mfkiwl/GPSDO_by_DF4IAH/HW/CAD/Eagle/cam/ZIP/20211031_sGPSDO_MCU_1V0/Preview/20211031_sGPSDO_MCU_1V0__Eagle.jpeg

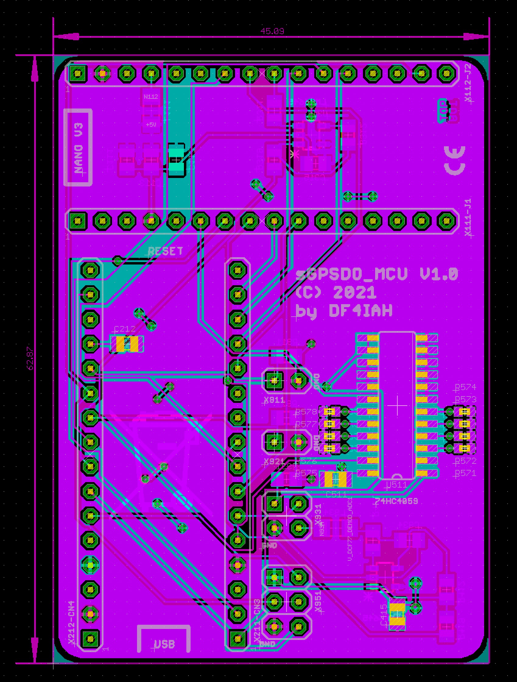
HW/CAD/Eagle/cam/ZIP/20211031_sGPSDO_MCU_1V0/Preview/20211031_sGPSDO_MCU_1V0__Eagle.jpeg
