mfkiwl/GPSDO_by_DF4IAH/README.md

# GPSDO_by_DF4IAH
GNSS or DCF77 disciplined OCXO based on hardware by DL4ZAO and DL7UKM.
