mfkiwl/GPSDO_by_DF4IAH/DOCS/01_MCU_Pinout/GPSDO_DF4IAH_STM32L432KC.jpeg

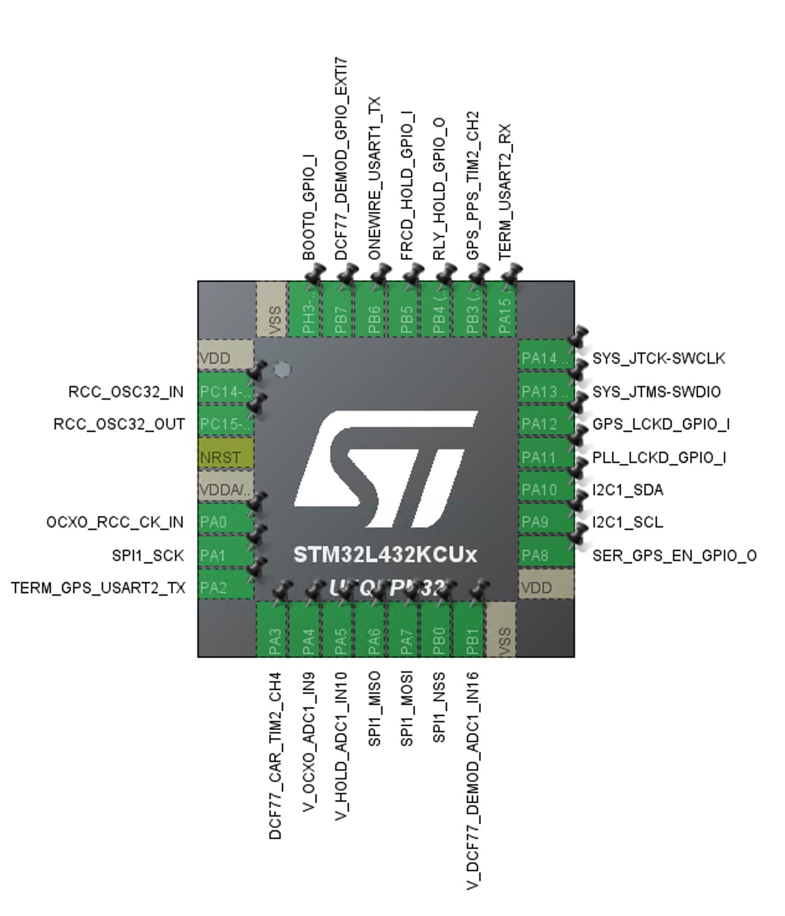
DOCS/01_MCU_Pinout/GPSDO_DF4IAH_STM32L432KC.jpeg
