mfkiwl/GPSDO_by_DF4IAH/HW/CAD/Eagle/cam/ZIP/20211025_DCF77_RX_1V0/Preview/Board_STP.jpeg

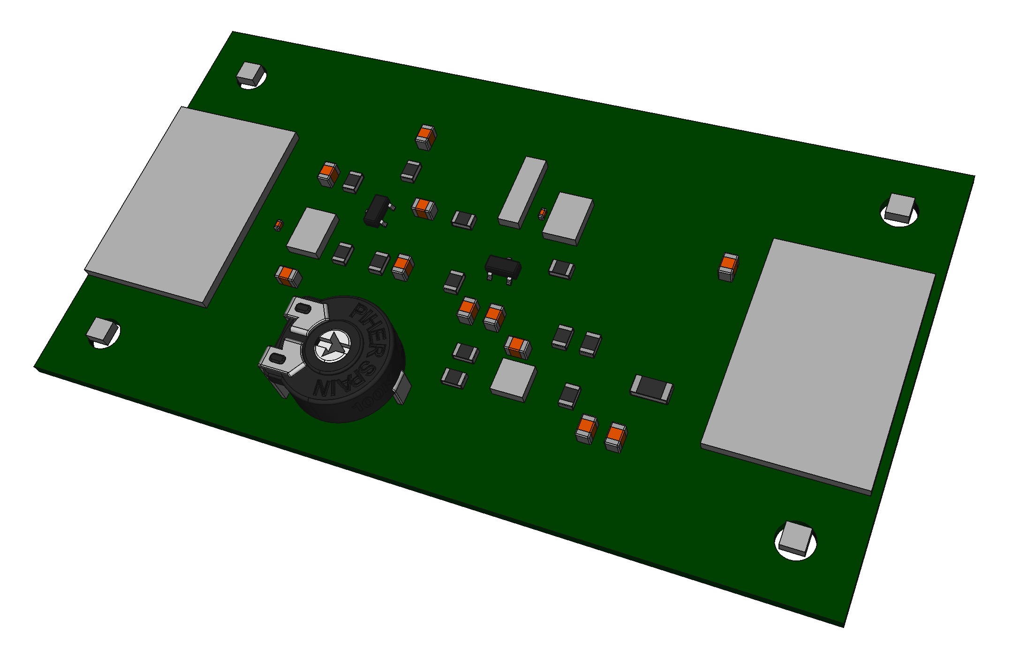
HW/CAD/Eagle/cam/ZIP/20211025_DCF77_RX_1V0/Preview/Board_STP.jpeg
