mfkiwl/GPSDO_by_DF4IAH/HW/CAD/Eagle/cam/ZIP/20211025_DCF77_RX_1V0/Preview/pp_top_6175b63559f43.jpeg

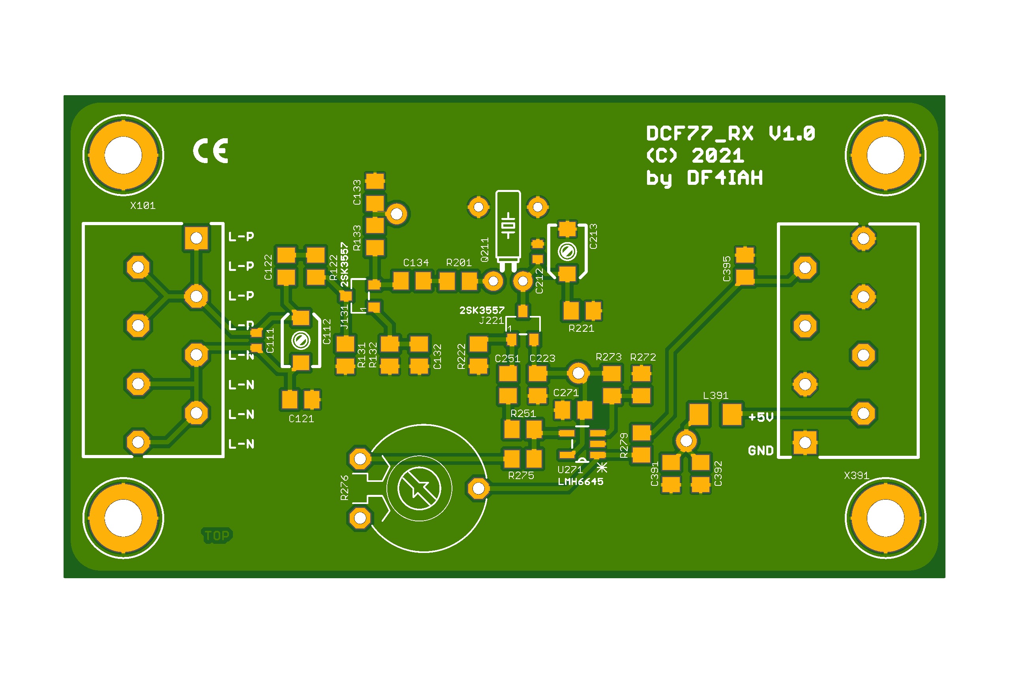
HW/CAD/Eagle/cam/ZIP/20211025_DCF77_RX_1V0/Preview/pp_top_6175b63559f43.jpeg
