mfkiwl/GPSDO_by_DF4IAH/HW/CAD/Eagle/cam/ZIP/20211031_sGPSDO_MCU_1V0/Preview/pp_bottom_617efd1f2c64e.jpeg

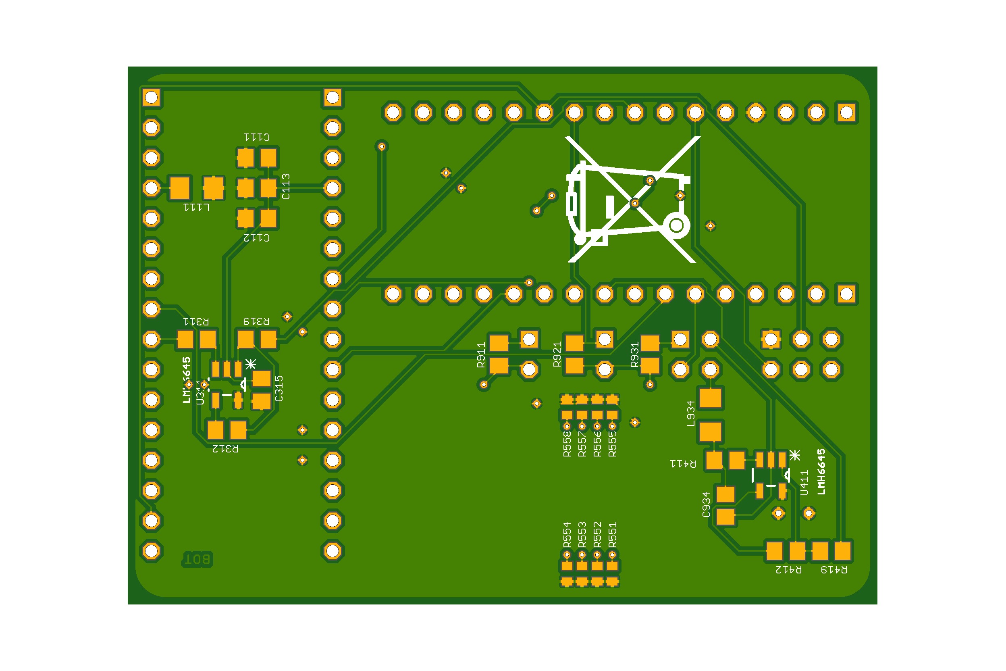
HW/CAD/Eagle/cam/ZIP/20211031_sGPSDO_MCU_1V0/Preview/pp_bottom_617efd1f2c64e.jpeg
