mfkiwl/GPSDO_by_DF4IAH/HW/CAD/Eagle/cam/ZIP/20211031_sGPSDO_MCU_1V0/Preview/pp_top_617efd0a4f2e5.jpeg

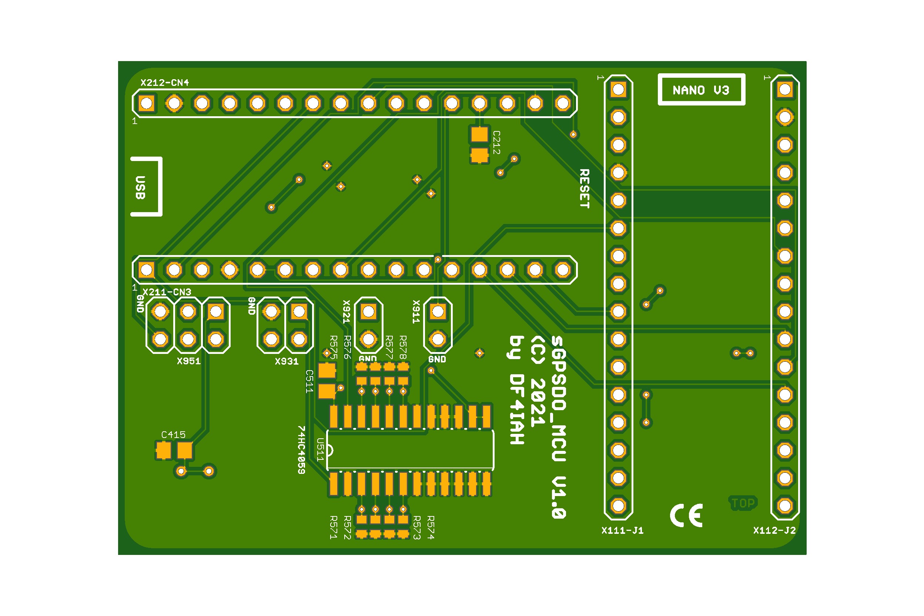
HW/CAD/Eagle/cam/ZIP/20211031_sGPSDO_MCU_1V0/Preview/pp_top_617efd0a4f2e5.jpeg
