mfkiwl/GPSDO_by_DF4IAH/CPLD/sGPSDO_MCU__divider/not_in_use/divider_test/div_mod_summary.html

div_mod Project Status (11/01/2021 - 13:03:21)
Project File: | divider_test.xise | Parser Errors: | No Errors
Module Name: | div_mod | Implementation State: | Fitted
Target Device: | xc2c64a-7VQ44 | Errors: | No Errors
Product Version: | ISE 14.7 | Warnings: | 2 Warnings (1 new)
Design Goal: | Balanced | Routing Results:
Design Strategy: | Xilinx Default (unlocked) | Timing Constraints:
Environment: | System Settings | Final Timing Score:

Detailed Reports | | | | | | [-]
Report Name | Status | Generated | Errors | Warnings | Infos
Synthesis Report | Current | Mon Nov 1 12:31:45 2021 | 0 | 1 Warning (1 new) | 0
Translation Report | Current | Mon Nov 1 13:03:12 2021 | 0 | 1 Warning (0 new) | 0
CPLD Fitter Report (Text) | Current | Mon Nov 1 13:03:14 2021 | 0 | 1 Warning (1 new) | 0
Power Report

Secondary Reports | | | [-]
Report Name | Status | Generated
Post-Fit Simulation Model Report

Date Generated: 11/01/2021 - 13:03:21
