mfkiwl/GPSDO_by_DF4IAH/CPLD/sGPSDO_MCU__divider/not_in_use/divider_test/div_mod_envsettings.html

System Settings

Environment Settings
Environment Variable | xst | ngdbuild
LD_LIBRARY_PATH | /opt/Xilinx/14.7/ISE_DS/ISE//lib/lin64: /opt/Xilinx/14.7/ISE_DS/ISE/lib/lin64: /opt/Xilinx/14.7/ISE_DS/ISE/smartmodel/lin64/installed_lin64/lib: /opt/Xilinx/14.7/ISE_DS/ISE/sysgen/lib: /opt/Xilinx/14.7/ISE_DS/EDK/lib/lin64: /opt/Xilinx/14.7/ISE_DS/common/lib/lin64 | /opt/Xilinx/14.7/ISE_DS/ISE//lib/lin64: /opt/Xilinx/14.7/ISE_DS/ISE/lib/lin64: /opt/Xilinx/14.7/ISE_DS/ISE/smartmodel/lin64/installed_lin64/lib: /opt/Xilinx/14.7/ISE_DS/ISE/sysgen/lib: /opt/Xilinx/14.7/ISE_DS/EDK/lib/lin64: /opt/Xilinx/14.7/ISE_DS/common/lib/lin64
LMC_HOME | /opt/Xilinx/14.7/ISE_DS/ISE/smartmodel/lin64/installed_lin64 | /opt/Xilinx/14.7/ISE_DS/ISE/smartmodel/lin64/installed_lin64

PATH

/opt/Xilinx/14.7/ISE_DS/ISE//bin/lin64:
/opt/Xilinx/14.7/ISE_DS/ISE/bin/lin64:
/opt/Xilinx/14.7/ISE_DS/ISE/sysgen/util:
/opt/Xilinx/14.7/ISE_DS/ISE/sysgen/bin:
/opt/Xilinx/14.7/ISE_DS/ISE/../../../DocNav:
/opt/Xilinx/14.7/ISE_DS/PlanAhead/bin:
/opt/Xilinx/14.7/ISE_DS/EDK/bin/lin64:
/opt/Xilinx/14.7/ISE_DS/EDK/gnu/microblaze/lin/bin:
/opt/Xilinx/14.7/ISE_DS/EDK/gnu/powerpc-eabi/lin/bin:
/opt/Xilinx/14.7/ISE_DS/EDK/gnu/arm/lin/bin:
/opt/Xilinx/14.7/ISE_DS/EDK/gnu/microblaze/linux_toolchain/lin64_be/bin:
/opt/Xilinx/14.7/ISE_DS/EDK/gnu/microblaze/linux_toolchain/lin64_le/bin:
/opt/Xilinx/14.7/ISE_DS/common/bin/lin64:
/usr/lib64/qt-3.3/bin:
/usr/local/bin:
/usr/bin:
/bin:
/usr/local/sbin:
/usr/sbin:
/sbin:
/home/ise/bin

/opt/Xilinx/14.7/ISE_DS/ISE//bin/lin64:
/opt/Xilinx/14.7/ISE_DS/ISE/bin/lin64:
/opt/Xilinx/14.7/ISE_DS/ISE/sysgen/util:
/opt/Xilinx/14.7/ISE_DS/ISE/sysgen/bin:
/opt/Xilinx/14.7/ISE_DS/ISE/../../../DocNav:
/opt/Xilinx/14.7/ISE_DS/PlanAhead/bin:
/opt/Xilinx/14.7/ISE_DS/EDK/bin/lin64:
/opt/Xilinx/14.7/ISE_DS/EDK/gnu/microblaze/lin/bin:
/opt/Xilinx/14.7/ISE_DS/EDK/gnu/powerpc-eabi/lin/bin:
/opt/Xilinx/14.7/ISE_DS/EDK/gnu/arm/lin/bin:
/opt/Xilinx/14.7/ISE_DS/EDK/gnu/microblaze/linux_toolchain/lin64_be/bin:
/opt/Xilinx/14.7/ISE_DS/EDK/gnu/microblaze/linux_toolchain/lin64_le/bin:
/opt/Xilinx/14.7/ISE_DS/common/bin/lin64:
/usr/lib64/qt-3.3/bin:
/usr/local/bin:
/usr/bin:
/bin:
/usr/local/sbin:
/usr/sbin:
/sbin:
/home/ise/bin
XILINX | /opt/Xilinx/14.7/ISE_DS/ISE/ | /opt/Xilinx/14.7/ISE_DS/ISE/
XILINX_DSP | /opt/Xilinx/14.7/ISE_DS/ISE | /opt/Xilinx/14.7/ISE_DS/ISE
XILINX_EDK | /opt/Xilinx/14.7/ISE_DS/EDK | /opt/Xilinx/14.7/ISE_DS/EDK
XILINX_PLANAHEAD | /opt/Xilinx/14.7/ISE_DS/PlanAhead | /opt/Xilinx/14.7/ISE_DS/PlanAhead

Synthesis Property Settings
Switch Name | Property Name | Value | Default Value
-ifn | | div_mod.prj
-ifmt | | mixed | MIXED
-ofn | | div_mod
-ofmt | | NGC | NGC
-p | | xbr
-top | | div_mod
-opt_mode | Optimization Goal | Speed | SPEED
-opt_level | Optimization Effort | 1 | 1
-iuc | Use synthesis Constraints File | NO | NO
-keep_hierarchy | Keep Hierarchy | Yes | YES
-netlist_hierarchy | Netlist Hierarchy | As_Optimized | as_optimized
-rtlview | Generate RTL Schematic | Yes | NO
-bus_delimiter | Bus Delimiter | <> | <>
-verilog2001 | Verilog 2001 | YES | YES
-fsm_extract | | YES | YES
-fsm_encoding | | Auto | AUTO
-safe_implementation | | No | NO
-resource_sharing | | YES | YES
-iobuf | | YES | YES
-equivalent_register_removal | | YES | YES

Translation Property Settings
Switch Name | Property Name | Value | Default Value
-intstyle | | ise | None
-dd | | _ngo | None
-p | | xc2c64a-VQ44-7 | None
-uc | | top_constraints.ucf | None

Operating System Information
Operating System Information | xst | ngdbuild
CPU Architecture/Speed | Intel(R) Core(TM) i9-10900K CPU @ 3.70GHz/3696.000 MHz | Intel(R) Core(TM) i9-10900K CPU @ 3.70GHz/3696.000 MHz
Host | localhost.localdomain | localhost.localdomain
OS Name | OracleServer | OracleServer
OS Release | Oracle Linux Server release 6.4 | Oracle Linux Server release 6.4
