mfkiwl/GPSDO_by_DF4IAH/CPLD/sGPSDO_MCU__divider/not_in_use/divider_test/C__/nppdf32Log/debuglog.txt

NPP_GetValue is called
NPP_GetValue is called
NPP_GetValue is called
NPP_GetValue is called
NPP_GetValue is called
NPP_GetValue is called
NPP_GetValue is called
NPP_GetValue is called
NPP_GetValue is called
NPP_GetValue is called
NPP_GetValue is called
NPP_GetValue is called
NPP_GetValue is called
NPP_GetValue is called
NPP_GetValue is called
NPP_GetValue is called
NPP_GetValue is called
NPP_GetValue is called
NPP_GetValue is called
NPP_GetValue is called
NPP_GetValue is called
NPP_GetValue is called
NPP_GetValue is called
NPP_GetValue is called
NPP_GetValue is called
NPP_GetValue is called
NPP_GetValue is called
NPP_GetValue is called
NPP_GetValue is called
NPP_GetValue is called
NPP_GetValue is called
NPP_GetValue is called
NPP_GetValue is called
NPP_GetValue is called
NPP_GetValue is called
NPP_GetValue is called
NPP_GetValue is called
NPP_GetValue is called
NPP_GetValue is called
NPP_GetValue is called
NPP_GetValue is called
NPP_GetValue is called
NPP_GetValue is called
NPP_GetValue is called
NPP_GetValue is called
NPP_GetValue is called
NPP_GetValue is called
NPP_GetValue is called
NPP_GetValue is called
NPP_GetValue is called
NPP_GetValue is called
NPP_GetValue is called
NPP_GetValue is called
NPP_GetValue is called
NPP_GetValue is called
NPP_GetValue is called
NPP_GetValue is called
NPP_GetValue is called
NPP_GetValue is called
NPP_GetValue is called
NPP_GetValue is called
NPP_GetValue is called
NPP_GetValue is called
NPP_GetValue is called
NPP_GetValue is called
NPP_GetValue is called
NPP_GetValue is called
NPP_GetValue is called
NPP_GetValue is called
NPP_GetValue is called
NPP_GetValue is called
NPP_GetValue is called
NPP_GetValue is called
NPP_GetValue is called
NPP_GetValue is called
NPP_GetValue is called
NPP_GetValue is called
NPP_GetValue is called
NPP_GetValue is called
NPP_GetValue is called
NPP_GetValue is called
NPP_GetValue is called
NPP_GetValue is called
NPP_GetValue is called
NPP_GetValue is called
NPP_GetValue is called
NPP_GetValue is called
NPP_GetValue is called
NPP_GetValue is called
NPP_GetValue is called
NPP_GetValue is called
NPP_GetValue is called
NPP_GetValue is called
NPP_GetValue is called
NPP_GetValue is called
NPP_GetValue is called
NPP_GetValue is called
NPP_GetValue is called
NPP_GetValue is called
NPP_GetValue is called
NPP_GetValue is called
NPP_GetValue is called
