mfkiwl/GPSDO_by_DF4IAH/HW/CAD/Eagle/DCF77_RX_1V0.pdf

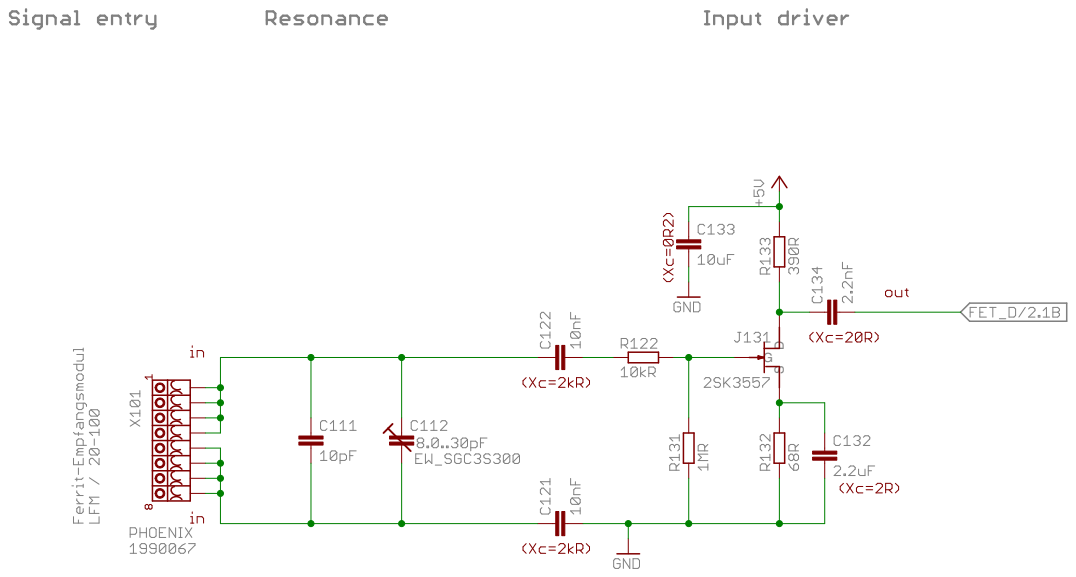
[picture p20: page 1]

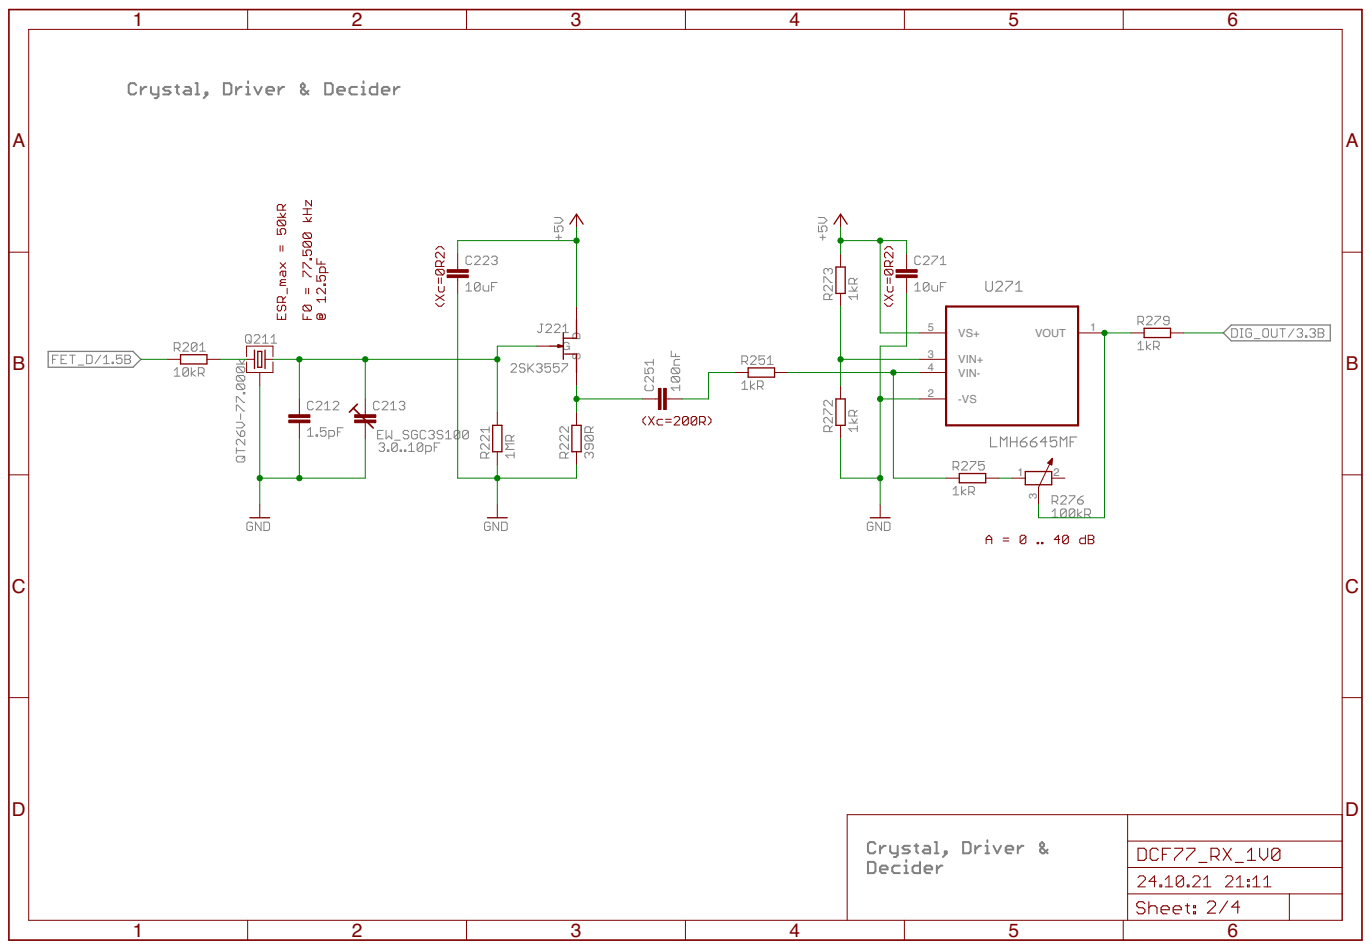
[picture p21: page 2]

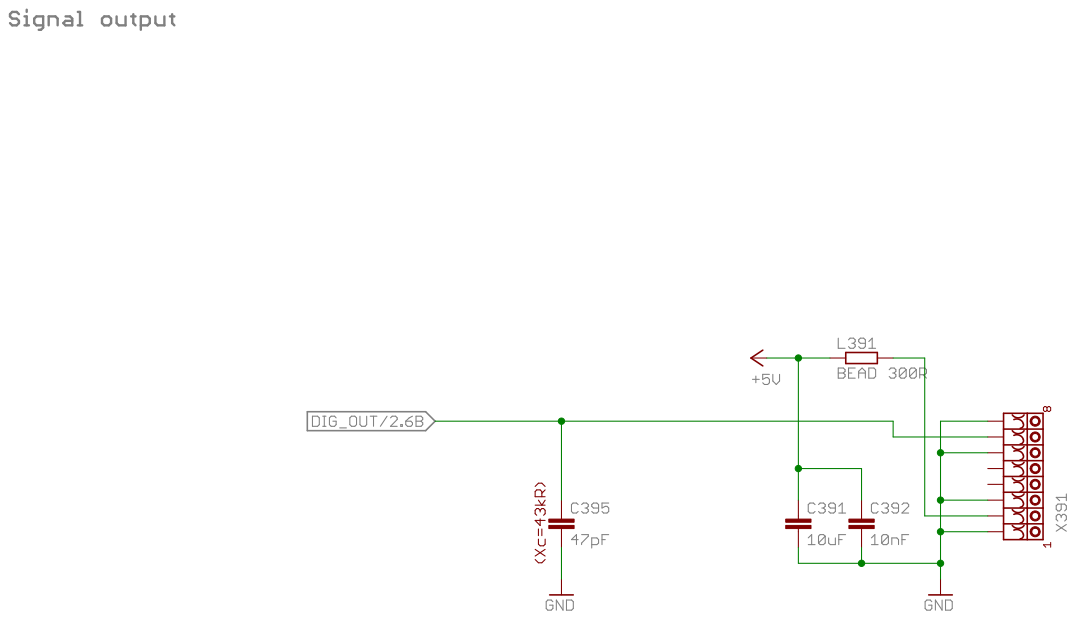
[picture p22: page 3]

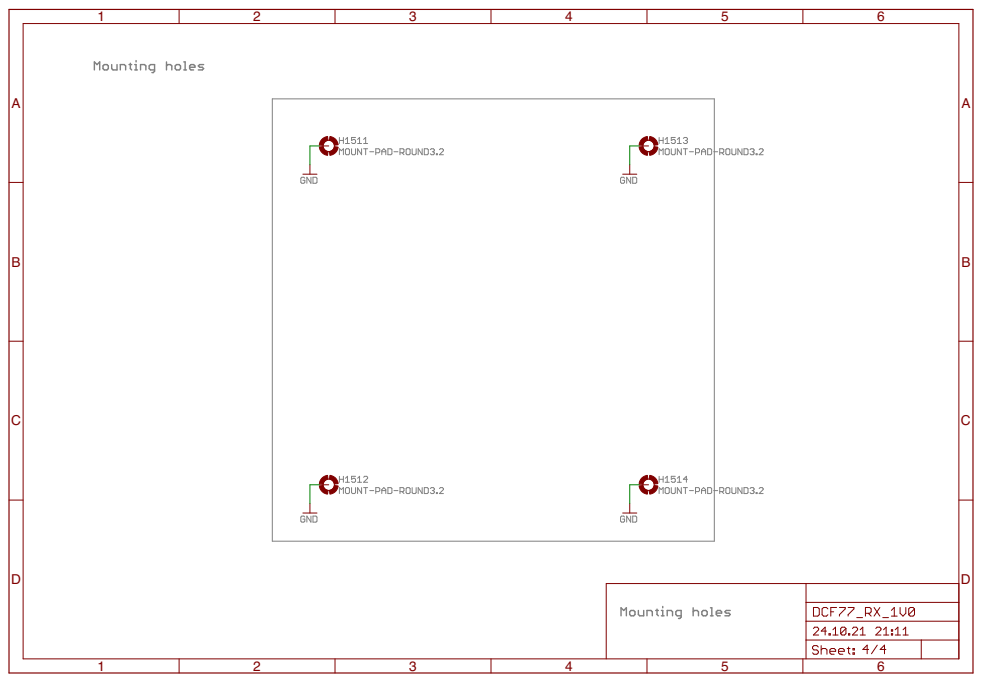
[picture p23: page 4]
