mfkiwl/GPSDO_by_DF4IAH/HW/CAD/LTspice_Simu/01_Crystal_AC-analysis.asc

C1: cap; 1p
C2: cap; 12.5p
L1: ind; 4.52
R1: res; 50k
R2: res; 10k
R3: res; 1Meg
V1: voltage; SINE(0 1m 77500); AC 1m 0
Named nets: 0, out, in
.ac oct 100 1000 1000000
