mfkiwl/GPSDO_by_DF4IAH/HW/CAD/LTspice_Simu/02_Crystal_and_nFET_AC-analysis.asc

C1: cap; 1p
C2: cap; 7.7p
C5: cap; 22n
J1: njf; 2SK3557
L1: ind; 4.52
R1: res; 50k
R2: res; 10k
R3: res; 1Meg
R4: res; 390
R8: res; 1k
R9: res; 1k
V1: voltage; SINE(0 1m 77500); AC 1 0
V2: voltage; 5
Named nets: 0, out1, in, v5v, out3
.ac lin 1000 50k 100k
