mfkiwl/GPSDO_by_DF4IAH/HW/CAD/LTspice_Simu/03_nFET_and_Crystal_and_nFET_AC-analysis.asc

C1: cap; 1p
C2: cap; 7.7p
C3: cap; 30p
C4: cap; 10n
C5: cap; 22n
C6: cap; 10n
C7: cap; 2.2µ
C8: cap; 2.2n
J1: njf; 2SK3557
J2: njf; 2SK3557
L1: ind; 4.52
L2: ind; 60m
R1: res; 50k
R2: res; 1Meg
R3: res; 1Meg
R4: res; 390
R5: res; 10k
R6: res; 10Meg
R7: res; 1Meg
R8: res; 1k
R9: res; 1k
R10: res; 68
R11: res; 390
R12: res; 10k
V1: voltage; SINE(0 1 77500); AC 5.623 0
V2: voltage; 5
Named nets: crystal, in, 0, v5v, driver, in2, preamp
.ac lin 1000 50k 100k
