mfkiwl/GPSDO_by_DF4IAH/HW/CAD/LTspice_Simu/04_nFET_and_Crystal_and_nFET__FET-fine-model_AC-analysis.asc

C1: cap; 1p
C2: cap; 8p
C3: cap; 30.5p
C4: cap; 10n
C5: cap; 22n
C6: cap; 10n
C7: cap; 2.2µ
C8: cap; 2.2n
C9: cap; 74f
C10: cap; 74f
C11: cap; 74f
C12: cap; 74f
J2: njf; 2SK3557
J3: njf; 2SK3557
L1: ind; 4.52
L2: ind; 60m
L3: ind; 132p
L4: ind; 924p
L5: ind; 524p
L6: ind; 132p
L7: ind; 924p
L8: ind; 132p
L9: ind; 924p
L10: ind; 524p
L11: ind; 132p
L12: ind; 924p
R1: res; 50k
R2: res; 1Meg
R3: res; 1Meg
R4: res; 390
R5: res; 10k
R6: res; 10Meg
R7: res; 1Meg
R8: res; 1k
R9: res; 1k
R10: res; 15
R11: res; 180
R12: res; 10k
V1: voltage; SINE(0 1.125 77500 0.001 0 0 120); AC 1.125 0
V2: voltage; 5
Named nets: crystal, in, 0, v5v, driver, in2, preamp, preamp_S
.ac lin 1000 50k 100k
Crystal
;op lin 1000 50k 100k
