mfkiwl/GPSDO_by_DF4IAH/HW/CAD/Eagle/sGPSDO_MCU_1V0.brd

## EAGLE design HW/CAD/Eagle/sGPSDO_MCU_1V0.brd (2021-10-31)

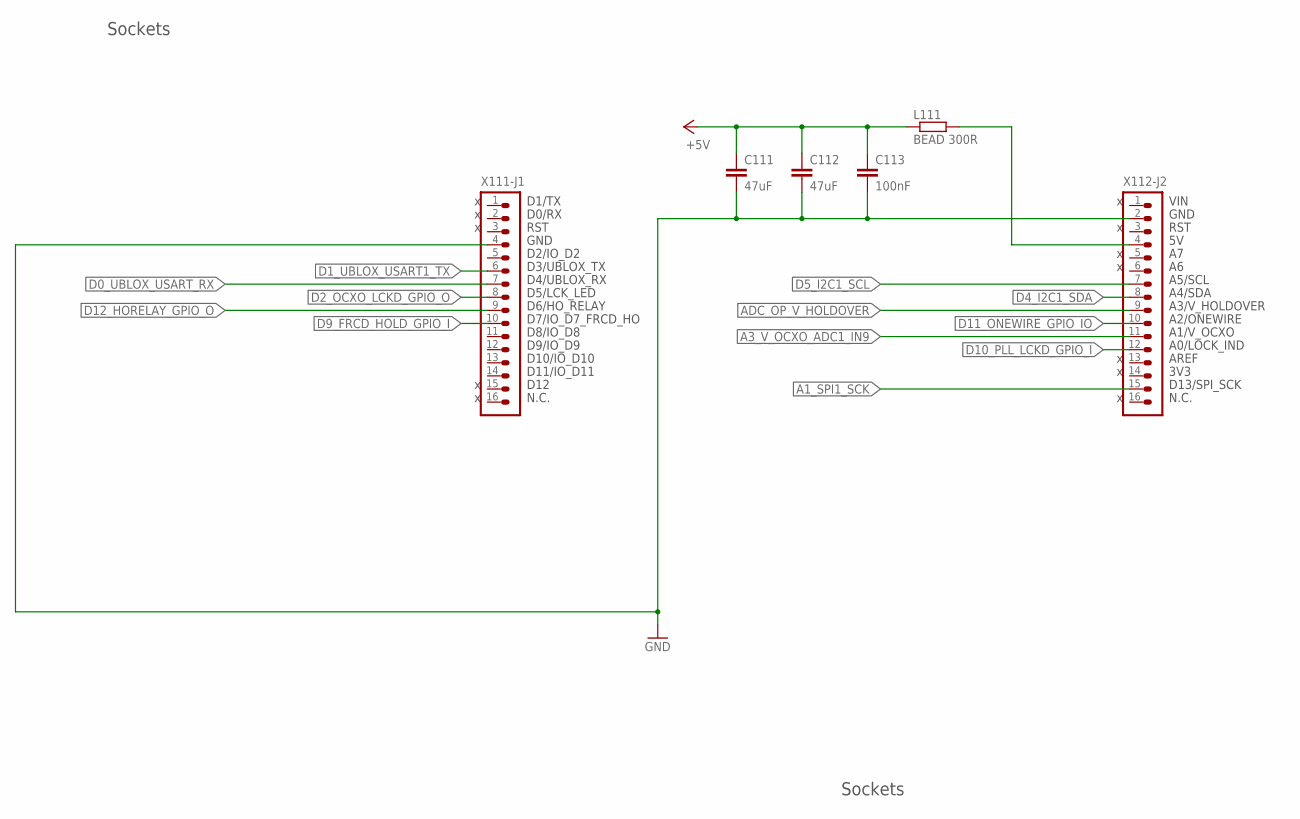
[picture p24: schematic sGPSDO_MCU_1V0.sch, sheet 1, Sockets]

Parts:
C111, C112: 47uF; C0805
C113: 100nF; C0805
L111: BEAD 300R; R1206
X111-J1, X112-J2: HEADER-1X16; 1X16

Connections:
+5V: C111.1, C112.1, C113.1, L111.1; also elsewhere on the board
A1_SPI1_SCK: X112-J2.15; also elsewhere on the board
A3_V_OCXO_ADC1_IN9: X112-J2.11; also elsewhere on the board
ADC_OP_V_HOLDOVER: X112-J2.9; also elsewhere on the board
D0_UBLOX_USART_RX: X111-J1.7; also elsewhere on the board
D1_UBLOX_USART1_TX: X111-J1.6; also elsewhere on the board
D2_OCXO_LCKD_GPIO_O: X111-J1.8; also elsewhere on the board
D4_I2C1_SDA: X112-J2.8; also elsewhere on the board
D5_I2C1_SCL: X112-J2.7; also elsewhere on the board
D9_FRCD_HOLD_GPIO_I: X111-J1.10; also elsewhere on the board
D10_PLL_LCKD_GPIO_I: X112-J2.12; also elsewhere on the board
D11_ONEWIRE_GPIO_IO: X112-J2.10; also elsewhere on the board
D12_HORELAY_GPIO_O: X111-J1.9; also elsewhere on the board
GND: C111.2, C112.2, C113.2, X111-J1.4, X112-J2.2; also elsewhere on the board
N112: L111.2, X112-J2.4

Notes on the sheet:
Sockets
A0/LOCK_IND
AREF
3V3
D13/SPI_SCK
N.C.
A1/V_OCXO
A2/ONEWIRE
A3/V_HOLDOVER
A4/SDA
A5/SCL
RST
GND
VIN
D12
D11/IO_D11
D10/IO_D10
D9/IO_D9
D8/IO_D8
D7/IO_D7_FRCD_HO
D6/HO_RELAY
D5/LCK_LED
D4/UBLOX_RX
D3/UBLOX_TX
D2/IO_D2
D0/RX
D1/TX

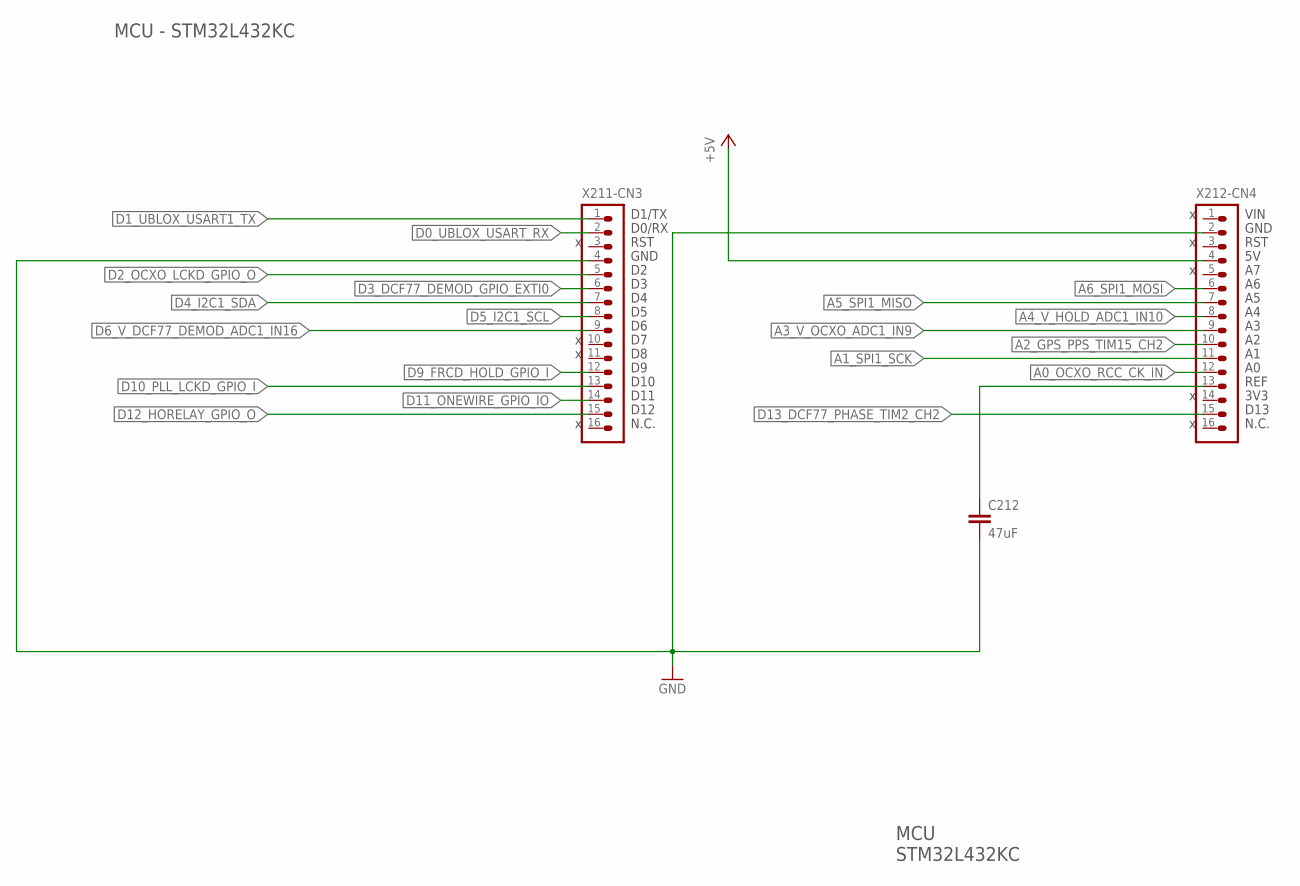
[picture p25: schematic sGPSDO_MCU_1V0.sch, sheet 2, MCU]

Parts:
C212: 47uF; C0805
X211-CN3, X212-CN4: HEADER-1X16; 1X16

Connections:
+5V: X212-CN4.4; also elsewhere on the board
A0_OCXO_RCC_CK_IN: X212-CN4.12; also elsewhere on the board
A1_SPI1_SCK: X212-CN4.11; also elsewhere on the board
A2_GPS_PPS_TIM15_CH2: X212-CN4.10; also elsewhere on the board
A3_V_OCXO_ADC1_IN9: X212-CN4.9; also elsewhere on the board
A4_V_HOLD_ADC1_IN10: X212-CN4.8; also elsewhere on the board
A5_SPI1_MISO: X212-CN4.7; also elsewhere on the board
A6_SPI1_MOSI: X212-CN4.6; also elsewhere on the board
D0_UBLOX_USART_RX: X211-CN3.2; also elsewhere on the board
D1_UBLOX_USART1_TX: X211-CN3.1; also elsewhere on the board
D2_OCXO_LCKD_GPIO_O: X211-CN3.5; also elsewhere on the board
D3_DCF77_DEMOD_GPIO_EXTI0: X211-CN3.6; also elsewhere on the board
D4_I2C1_SDA: X211-CN3.7; also elsewhere on the board
D5_I2C1_SCL: X211-CN3.8; also elsewhere on the board
D6_V_DCF77_DEMOD_ADC1_IN16: X211-CN3.9; also elsewhere on the board
D9_FRCD_HOLD_GPIO_I: X211-CN3.12; also elsewhere on the board
D10_PLL_LCKD_GPIO_I: X211-CN3.13; also elsewhere on the board
D11_ONEWIRE_GPIO_IO: X211-CN3.14; also elsewhere on the board
D12_HORELAY_GPIO_O: X211-CN3.15; also elsewhere on the board
D13_DCF77_PHASE_TIM2_CH2: X212-CN4.15; also elsewhere on the board
GND: C212.2, X211-CN3.4, X212-CN4.2; also elsewhere on the board
VREF: C212.1, X212-CN4.13

Notes on the sheet:
MCU - STM32L432KC
MCU STM32L432KC
REF
3V3
D13
N.C.
RST
GND
VIN
D12
D11
D10
D0/RX
D1/TX

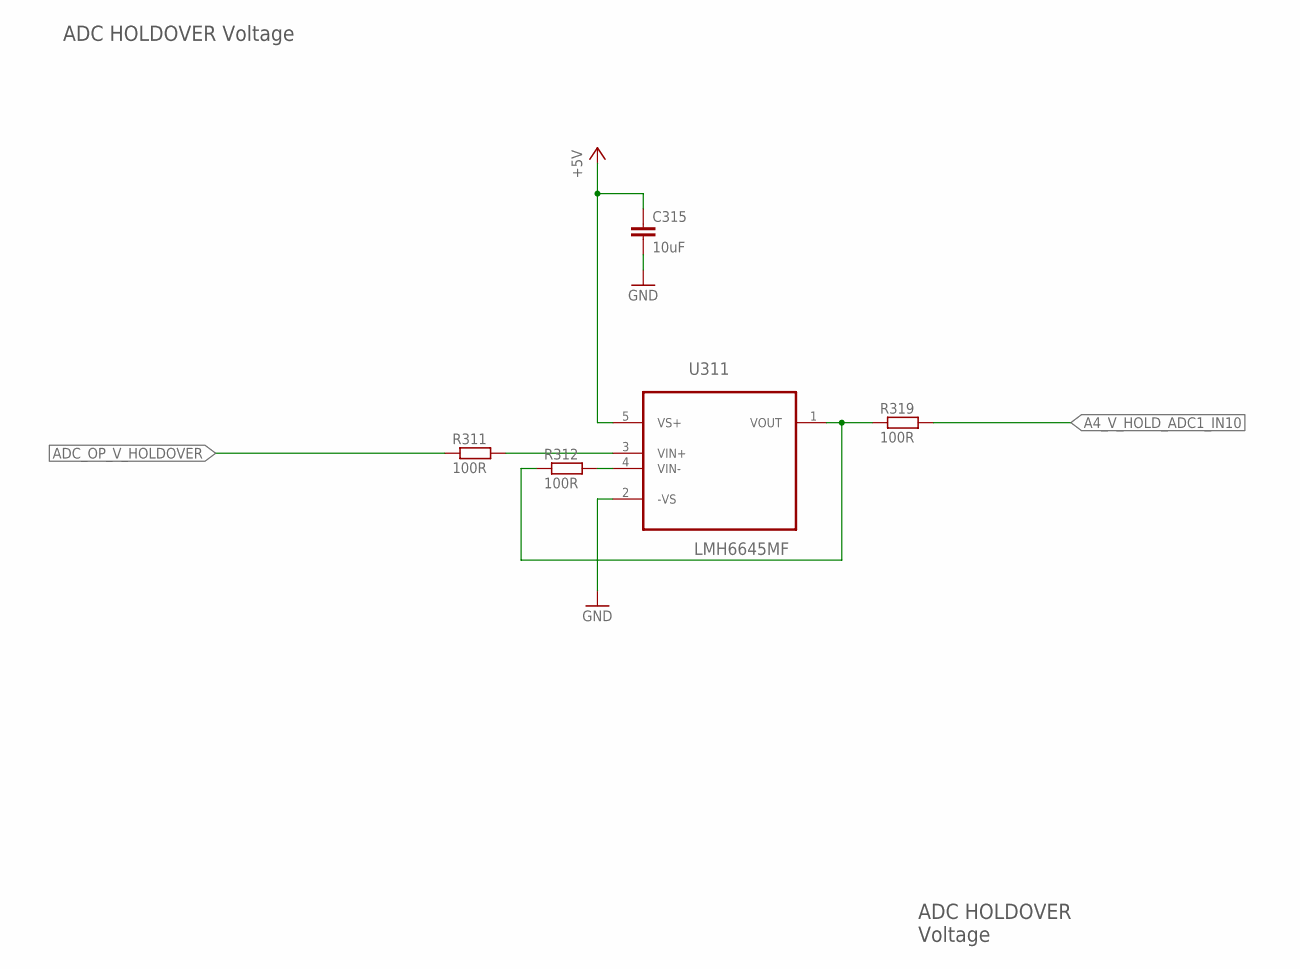
[picture p26: schematic sGPSDO_MCU_1V0.sch, sheet 3, ADC HOLDOVER Voltage]

Parts:
C315: 10uF; C0805
R311, R312, R319: 100R; R0805
U311: LMH6645MF; SOT-23-5

Connections:
+5V: C315.1, U311.5 (VS+); also elsewhere on the board
A4_V_HOLD_ADC1_IN10: R319.2; also elsewhere on the board
ADC_OP_V_HOLDOVER: R311.1; also elsewhere on the board
GND: C315.2, U311.2 (-VS); also elsewhere on the board
N311: R311.2, U311.3 (VIN+)
N312: R312.2, U311.4 (VIN-)
N319: R312.1, R319.1, U311.1 (VOUT)

Notes on the sheet:
ADC HOLDOVER Voltage
ADC HOLDOVER Voltage

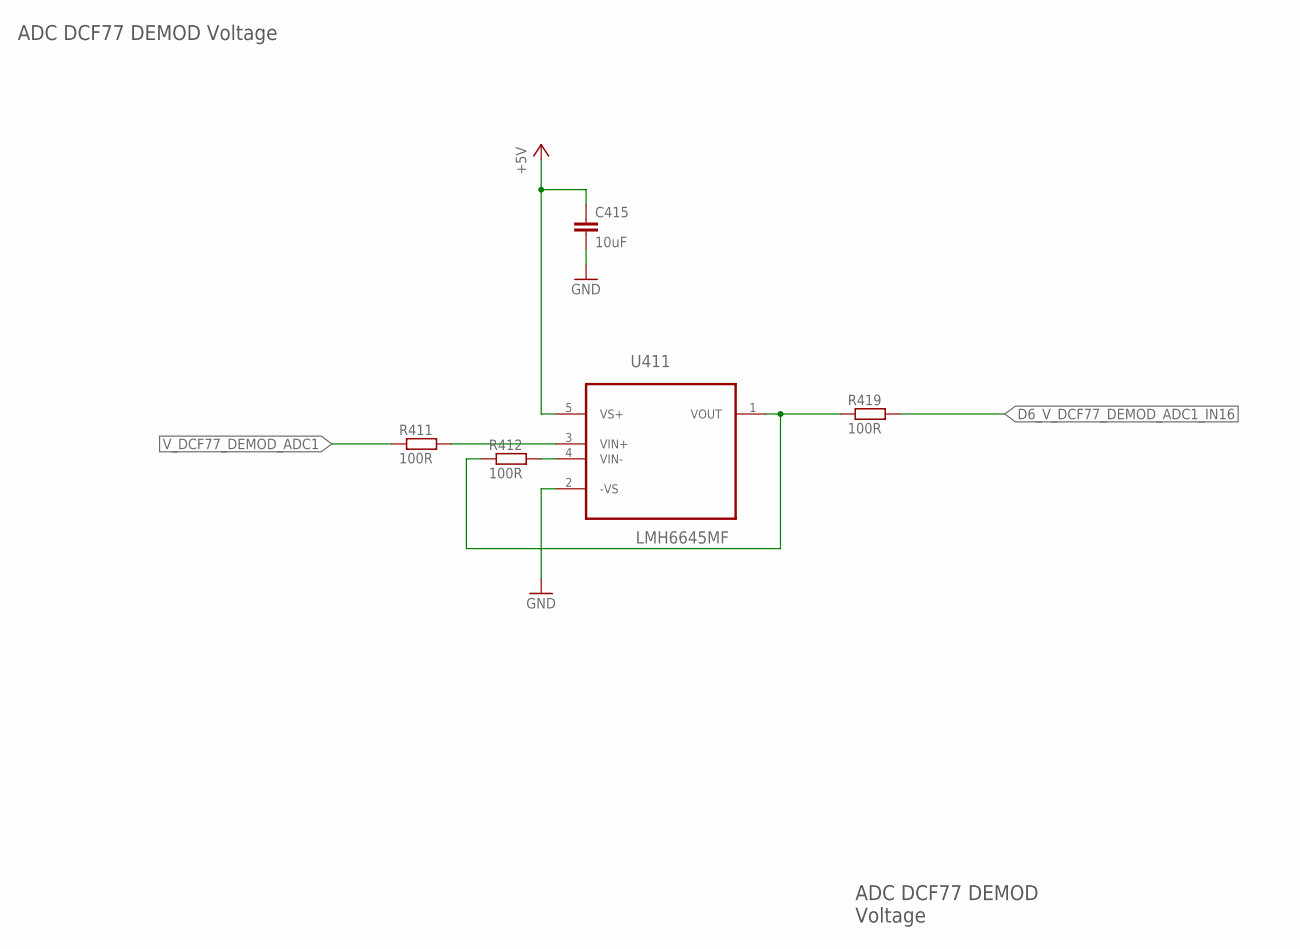
[picture p27: schematic sGPSDO_MCU_1V0.sch, sheet 4, ADC DCF77 DEMOD Voltage]

Parts:
C415: 10uF; C0805
R411, R412, R419: 100R; R0805
U411: LMH6645MF; SOT-23-5

Connections:
+5V: C415.1, U411.5 (VS+); also elsewhere on the board
D6_V_DCF77_DEMOD_ADC1_IN16: R419.2; also elsewhere on the board
GND: C415.2, U411.2 (-VS); also elsewhere on the board
N411: R411.2, U411.3 (VIN+)
N412: R412.2, U411.4 (VIN-)
N419: R412.1, R419.1, U411.1 (VOUT)
V_DCF77_DEMOD_ADC1: R411.1; also elsewhere on the board

Notes on the sheet:
ADC DCF77 DEMOD Voltage
ADC DCF77 DEMOD Voltage

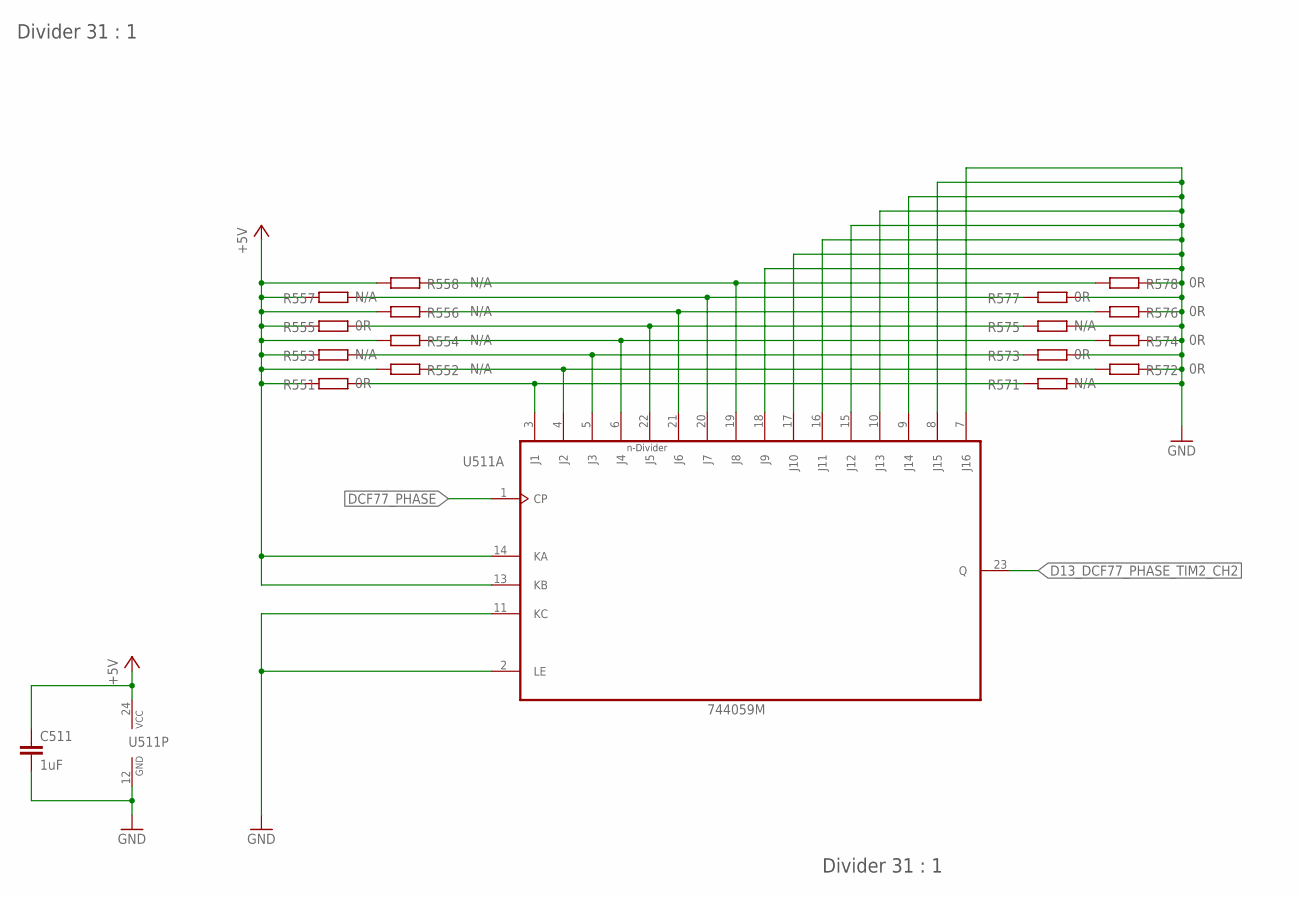
[picture p28: schematic sGPSDO_MCU_1V0.sch, sheet 5, Divider 31:1]

Parts:
C511: 1uF; C0805
R551, R555, R572, R573, R574, R576, R577, R578: 0R; R0402
R552, R553, R554, R556, R557, R558, R571, R575: N/A; R0402
U511: 744059M; SO24

Connections:
+5V: C511.1, R551.1, R552.1, R553.1, R554.1, R555.1, R556.1, R557.1, R558.1, U511.13 (KB), U511.14 (KA), U511.24 (VCC); also elsewhere on the board
D13_DCF77_PHASE_TIM2_CH2: U511.23 (Q); also elsewhere on the board
DCF77_PHASE: U511.1 (CP); also elsewhere on the board
GND: C511.2, R571.2, R572.2, R573.2, R574.2, R575.2, R576.2, R577.2, R578.2, U511.2 (LE), U511.7 (J16), U511.8 (J15), U511.9 (J14), U511.10 (J13), U511.11 (KC), U511.12 (GND), U511.15 (J12), U511.16 (J11), U511.17 (J10), U511.18 (J9); also elsewhere on the board
N551: R551.2, R571.1, U511.3 (J1)
N552: R552.2, R572.1, U511.4 (J2)
N553: R553.2, R573.1, U511.5 (J3)
N554: R554.2, R574.1, U511.6 (J4)
N555: R555.2, R575.1, U511.22 (J5)
N556: R556.2, R576.1, U511.21 (J6)
N557: R557.2, R577.1, U511.20 (J7)
N558: R558.2, R578.1, U511.19 (J8)

Notes on the sheet:
Divider 31 : 1

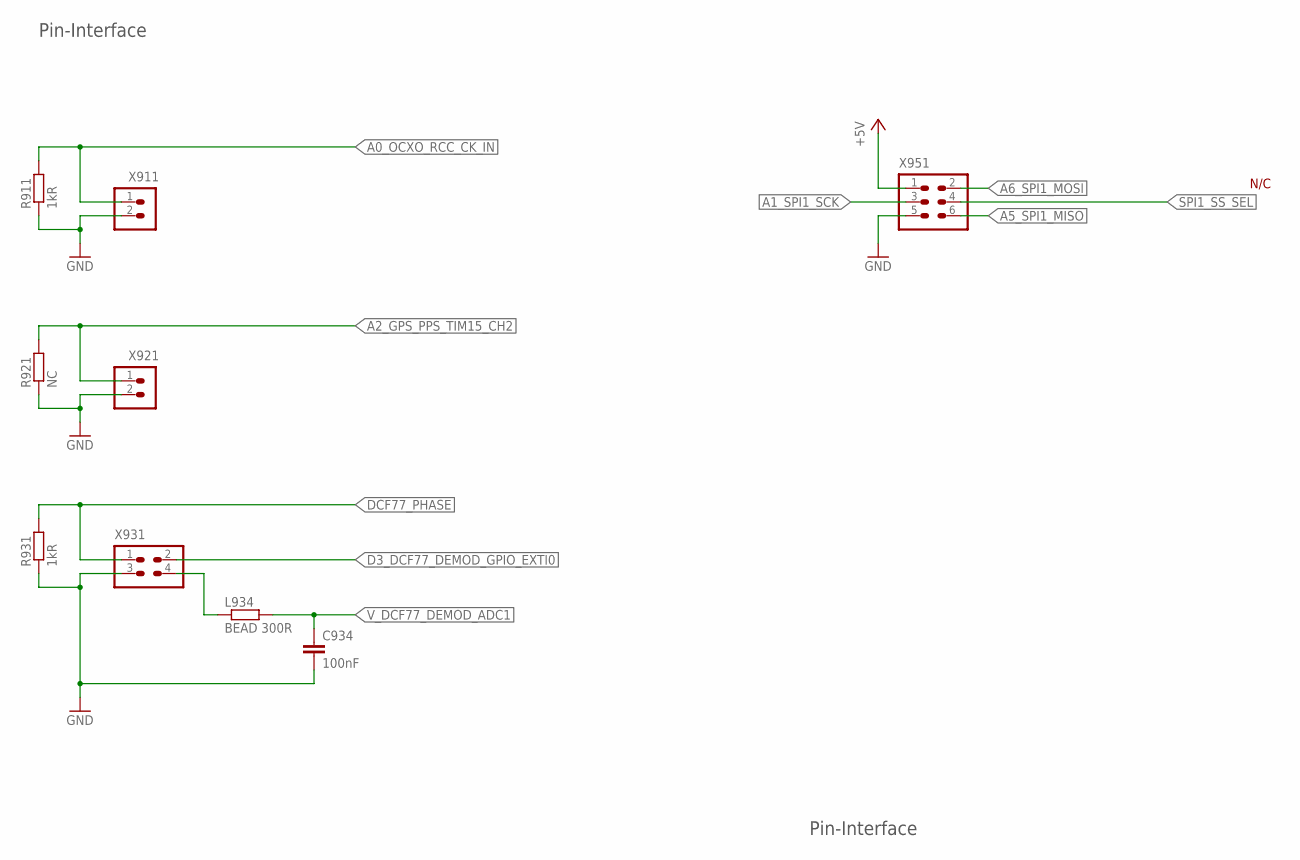
[picture p29: schematic sGPSDO_MCU_1V0.sch, sheet 6, Pin-Interface]

Parts:
C934: 100nF; C0805
L934: BEAD 300R; R1206
R911, R931: 1kR; R0805
R921: NC; R0805
X911, X921: HEADER-1X2; 1X02
X931: HEADER-2X2; 2X02
X951: HEADER-2X3; 2X03

Connections:
+5V: X951.1; also elsewhere on the board
A0_OCXO_RCC_CK_IN: R911.2, X911.1; also elsewhere on the board
A1_SPI1_SCK: X951.3; also elsewhere on the board
A2_GPS_PPS_TIM15_CH2: R921.2, X921.1; also elsewhere on the board
A5_SPI1_MISO: X951.6; also elsewhere on the board
A6_SPI1_MOSI: X951.2; also elsewhere on the board
D3_DCF77_DEMOD_GPIO_EXTI0: X931.2; also elsewhere on the board
DCF77_PHASE: R931.2, X931.1; also elsewhere on the board
GND: C934.2, R911.1, R921.1, R931.1, X911.2, X921.2, X931.3, X951.5; also elsewhere on the board
N934: L934.1, X931.4
SPI1_SS_SEL: X951.4
V_DCF77_DEMOD_ADC1: C934.1, L934.2; also elsewhere on the board

Notes on the sheet:
Pin-Interface
N/C

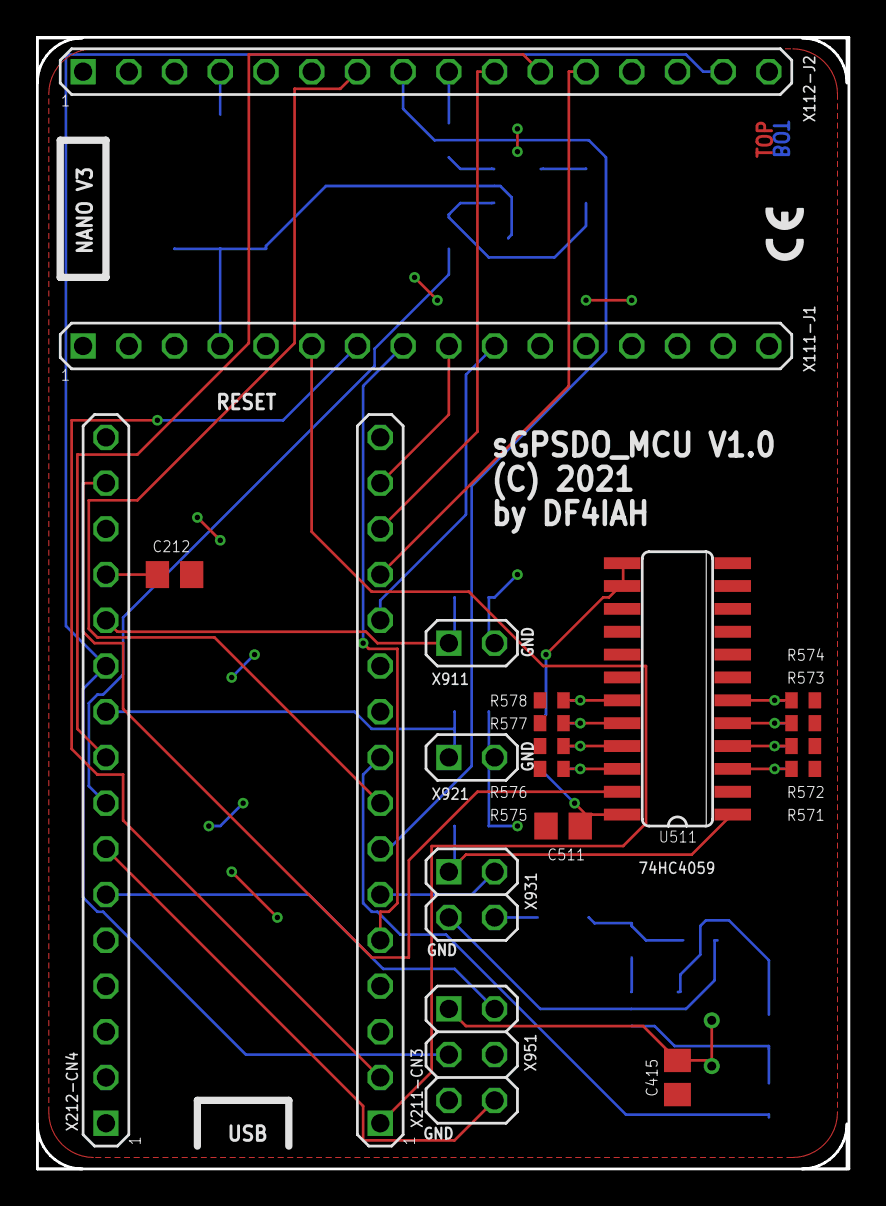
[picture p30: board sGPSDO_MCU_1V0.brd from above]

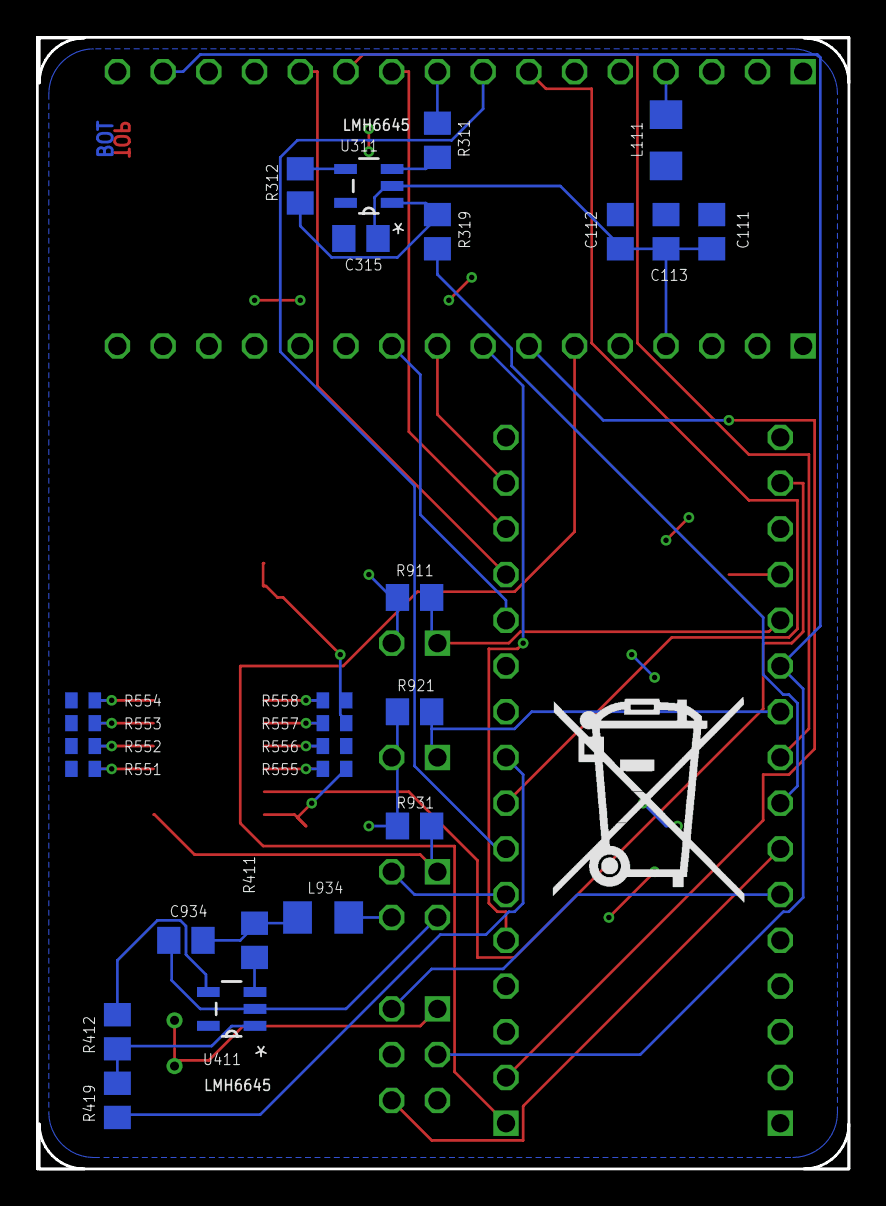
[picture p31: board sGPSDO_MCU_1V0.brd from below]

Board: 2 copper layers, 45.1 x 62.9 mm, 46 parts (26 on the bottom side), 41 nets.
