mfkiwl/GPSDO_by_DF4IAH/HW/CAD/Eagle/cam/ZIP/20211025_DCF77_RX_1V0/DCF77_RX_1V0.brd

## EAGLE design HW/CAD/Eagle/cam/ZIP/20211025_DCF77_RX_1V0/DCF77_RX_1V0.brd (2021-10-24)

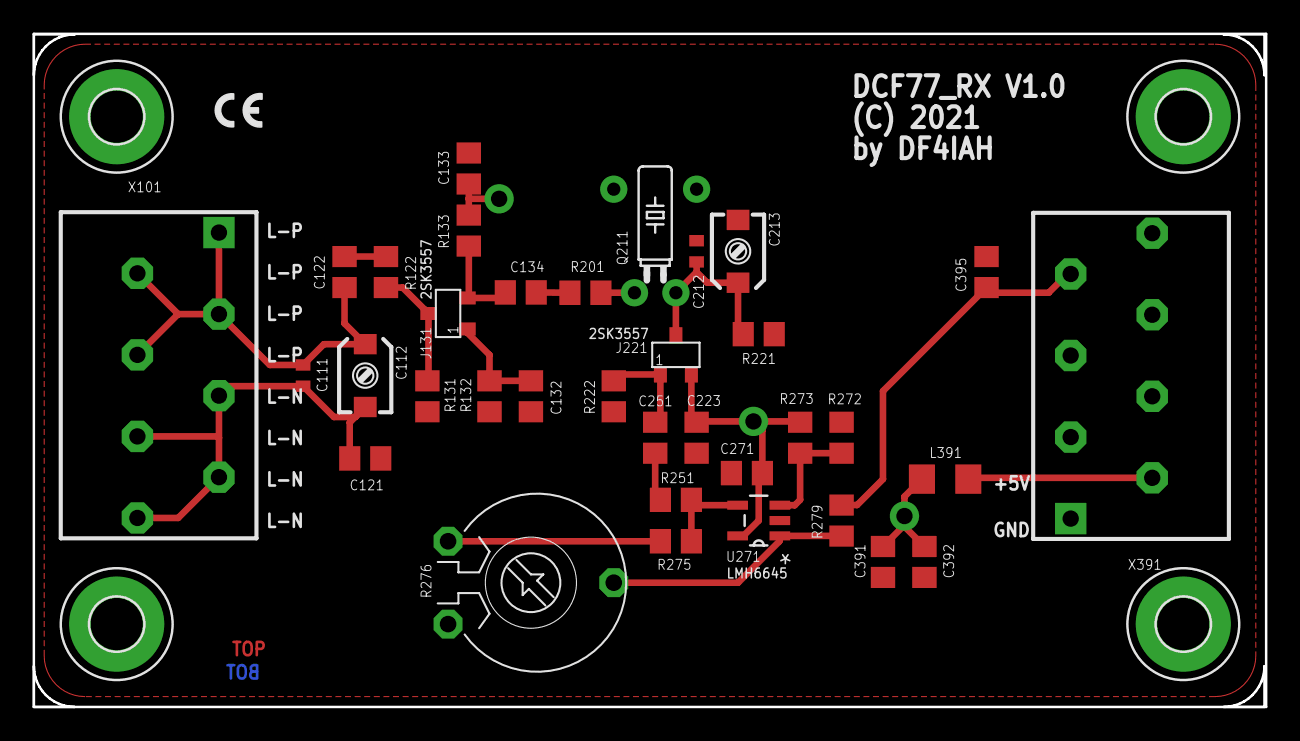
[picture p32: board DCF77_RX_1V0.brd from above]

Board: 2 copper layers, 75.6 x 41.3 mm, 39 parts (0 on the bottom side), 19 nets.

Parts:
C111: 10pF; C0402
C112: EW_SGC3S300; 4MM5_X_3MM2__EW_SGC3S
C121, C122, C392: 10nF; C0805
C132: 2.2uF; C0805
C133, C223, C271, C391: 10uF; C0805
C134: 2.2nF; C0805
C212: 1.5pF; C0402
C213: EW_SGC3S100; 4MM5_X_3MM2__EW_SGC3S
C251: 100nF; C0805
C395: 47pF; C0805
H1511, H1512, H1513, H1514: MOUNT-PAD-ROUND3.2; 3,2-PAD
J131, J221: 2SK3557; SOT23-3
L391: BEAD 300R; R1206
Q211: QT26V-77.000k; QT26V_QST
R122, R201: 10kR; R0805
R131, R221: 1MR; R0805
R132: 68R; R0805
R133, R222: 390R; R0805
R251, R272, R273, R275, R279: 1kR; R0805
R276: 100kR; PT-10
U271: LMH6645MF; SOT-23-5
X101, X391: PHOENIX_1990067_1X8X2MM50_PTSA-0-5

Connections:
+5V: C133.1, C223.1, C271.1, C391.1, C392.1, J221.P$2, L391.1, R133.2, R273.2, U271.5
DIG_OUT: C395.1, R279.2, X391.7
FET_D: C134.2, R201.1
GND: C121.2, C132.2, C133.2, C212.2, C213.CSTAT, C223.2, C271.2, C391.2, C392.2, C395.2, H1511.B3,2, H1512.B3,2, H1513.B3,2, H1514.B3,2, Q211.3, Q211.4, R131.1, R132.1, R221.1, R222.1, R272.1, U271.2, X391.1, X391.3, X391.6, X391.8
N101: C111.2, C112.CSTAT, C121.1, X101.5, X101.6, X101.7, X101.8
N102: C111.1, C112.CROT, C122.1, X101.1, X101.2, X101.3, X101.4
N122: C122.2, R122.1
N131: J131.P$3, R122.2, R131.2
N132: C132.1, J131.P$1, R132.2
N133: C134.1, J131.P$2, R133.1
N211: Q211.1, R201.2
N221: C212.1, C213.CROT, J221.P$3, Q211.2, R221.2
N222: C251.1, J221.P$1, R222.2
N251: C251.2, R251.1
N271: R276.3, R279.1, U271.1
N272: R272.2, R273.1, U271.3
N273: R251.2, R275.1, U271.4
N275: R275.2, R276.1
N391: L391.2, X391.2
