mfkiwl/GPSDO_by_DF4IAH/SW/GPSDO_by_DF4IAH/Core/Inc/main.h

#define NoD7_RCC_OSC32_IN_Pin GPIO_PIN_14
#define NoD7_RCC_OSC32_IN_GPIO_Port GPIOC
#define NoD8_RCC_OSC32_OUT_Pin GPIO_PIN_15
#define NoD8_RCC_OSC32_OUT_GPIO_Port GPIOC
#define A0_OCXO_RCC_CK_IN_Pin GPIO_PIN_0
#define A0_OCXO_RCC_CK_IN_GPIO_Port GPIOA
#define A1_SPI1_SCK_Pin GPIO_PIN_1
#define A1_SPI1_SCK_GPIO_Port GPIOA
#define NoA7_TERMINAL_USART2_TX_Pin GPIO_PIN_2
#define NoA7_TERMINAL_USART2_TX_GPIO_Port GPIOA
#define A2_GPS_PPS_TIM15_CH2_Pin GPIO_PIN_3
#define A2_GPS_PPS_TIM15_CH2_GPIO_Port GPIOA
#define A3_V_OCXO_ADC1_IN9_Pin GPIO_PIN_4
#define A3_V_OCXO_ADC1_IN9_GPIO_Port GPIOA
#define A4_V_HOLD_ADC1_IN10_Pin GPIO_PIN_5
#define A4_V_HOLD_ADC1_IN10_GPIO_Port GPIOA
#define A5_SPI1_MISO_Pin GPIO_PIN_6
#define A5_SPI1_MISO_GPIO_Port GPIOA
#define A6_SPI1_MOSI_Pin GPIO_PIN_7
#define A6_SPI1_MOSI_GPIO_Port GPIOA
#define D3_DCF77_DEMOD_GPIO_EXTI0_Pin GPIO_PIN_0
#define D3_DCF77_DEMOD_GPIO_EXTI0_GPIO_Port GPIOB
#define D6_V_DCF77_DEMOD_ADC1_IN16_Pin GPIO_PIN_1
#define D6_V_DCF77_DEMOD_ADC1_IN16_GPIO_Port GPIOB
#define D9_FRCD_HOLD_GPIO_I_Pin GPIO_PIN_8
#define D9_FRCD_HOLD_GPIO_I_GPIO_Port GPIOA
#define D1_UBLOX_USART1_TX_Pin GPIO_PIN_9
#define D1_UBLOX_USART1_TX_GPIO_Port GPIOA
#define D0_UBLOX_USART1_RX_Pin GPIO_PIN_10
#define D0_UBLOX_USART1_RX_GPIO_Port GPIOA
#define D10_PLL_LCKD_GPIO_I_Pin GPIO_PIN_11
#define D10_PLL_LCKD_GPIO_I_GPIO_Port GPIOA
#define D2_OCXO_LCKD_GPIO_O_Pin GPIO_PIN_12
#define D2_OCXO_LCKD_GPIO_O_GPIO_Port GPIOA
#define NoJ1J2_SYS_JTMS_SWDIO_Pin GPIO_PIN_13
#define NoJ1J2_SYS_JTMS_SWDIO_GPIO_Port GPIOA
#define NoJ1J2_SYS_JTCK_SWCLK_Pin GPIO_PIN_14
#define NoJ1J2_SYS_JTCK_SWCLK_GPIO_Port GPIOA
#define NoJ1J2_TERMINAL_USART2_RX_Pin GPIO_PIN_15
#define NoJ1J2_TERMINAL_USART2_RX_GPIO_Port GPIOA
#define D13_DCF77_PHASE_TIM2_CH2_Pin GPIO_PIN_3
#define D13_DCF77_PHASE_TIM2_CH2_GPIO_Port GPIOB
#define D12_HoRelay_GPIO_O_Pin GPIO_PIN_4
#define D12_HoRelay_GPIO_O_GPIO_Port GPIOB
#define D11_ONEWIRE_GPIO_IO_Pin GPIO_PIN_5
#define D11_ONEWIRE_GPIO_IO_GPIO_Port GPIOB
#define D5_I2C1_SCL_Pin GPIO_PIN_6
#define D5_I2C1_SCL_GPIO_Port GPIOB
#define D4_I2C1_SDA_Pin GPIO_PIN_7
#define D4_I2C1_SDA_GPIO_Port GPIOB
#define NoJ1J2_BOOT0_GPIO_I_Pin GPIO_PIN_3
#define NoJ1J2_BOOT0_GPIO_I_GPIO_Port GPIOH
#define ONEWIRE_DEVICES_MAX								2
#define ONEWIRE_DS18B20_ALARM_LO						40
#define ONEWIRE_DS18B20_ALARM_HI						50
#define UBLOX_MAX_CH									24
#define SW_PLL_TUNE_FAST								 50000.0f
#define SW_PLL_TUNE_SLOW								200000.0f
