mfkiwl/GPSDO_by_DF4IAH/SW/GPSDO_by_DF4IAH/Core/Src/adc.c

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
/* Includes ------------------------------------------------------------------*/
#include "adc.h"

/* USER CODE BEGIN 0 */

ADC_ChannelConfTypeDef adcChConfig 						= { 0 };

uint16_t gAdcCh9_val 									= 0U;
uint16_t gAdcCh10_val 									= 0U;
uint16_t gAdcCh16_val 									= 0U;
uint16_t gAdcVrefint_val								= 0U;

const float VREFINT_CAL 								= 65536 * ADC_VREFINT / 3.0f;
float gAdc_VDDA											= 0.0f;
float gAdcCh9_volts										= 0.0f;
float gAdcCh10_volts									= 0.0f;
float gAdcCh16_volts									= 0.0f;

uint16_t adc_dma_buf[5] 								= { 0 };
const uint32_t ADC_DMA_Buf_Len 							= sizeof(adc_dma_buf) / sizeof(uint16_t);



/* USER CODE END 0 */

ADC_HandleTypeDef hadc1;
DMA_HandleTypeDef hdma_adc1;

/* ADC1 init function */
void MX_ADC1_Init(void)
{

  ADC_ChannelConfTypeDef sConfig = {0};

  /** Common config
  */
  hadc1.Instance = ADC1;
  hadc1.Init.ClockPrescaler = ADC_CLOCK_ASYNC_DIV6;
  hadc1.Init.Resolution = ADC_RESOLUTION_12B;
  hadc1.Init.DataAlign = ADC_DATAALIGN_RIGHT;
  hadc1.Init.ScanConvMode = ADC_SCAN_ENABLE;
  hadc1.Init.EOCSelection = ADC_EOC_SEQ_CONV;
  hadc1.Init.LowPowerAutoWait = DISABLE;
  hadc1.Init.ContinuousConvMode = DISABLE;
  hadc1.Init.NbrOfConversion = 5;
  hadc1.Init.DiscontinuousConvMode = DISABLE;
  hadc1.Init.ExternalTrigConv = ADC_SOFTWARE_START;
  hadc1.Init.ExternalTrigConvEdge = ADC_EXTERNALTRIGCONVEDGE_NONE;
  hadc1.Init.DMAContinuousRequests = ENABLE;
  hadc1.Init.Overrun = ADC_OVR_DATA_PRESERVED;
  hadc1.Init.OversamplingMode = ENABLE;
  hadc1.Init.Oversampling.Ratio = ADC_OVERSAMPLING_RATIO_256;
  hadc1.Init.Oversampling.RightBitShift = ADC_RIGHTBITSHIFT_4;
  hadc1.Init.Oversampling.TriggeredMode = ADC_TRIGGEREDMODE_SINGLE_TRIGGER;
  hadc1.Init.Oversampling.OversamplingStopReset = ADC_REGOVERSAMPLING_CONTINUED_MODE;
  if (HAL_ADC_Init(&hadc1) != HAL_OK)
  {
    Error_Handler();
  }

  /** Configure Regular Channel
  */
  sConfig.Channel = ADC_CHANNEL_VREFINT;
  sConfig.Rank = ADC_REGULAR_RANK_1;
  sConfig.SamplingTime = ADC_SAMPLETIME_247CYCLES_5;
  sConfig.SingleDiff = ADC_SINGLE_ENDED;
  sConfig.OffsetNumber = ADC_OFFSET_NONE;
  sConfig.Offset = 0;
  if (HAL_ADC_ConfigChannel(&hadc1, &sConfig) != HAL_OK)
  {
    Error_Handler();
  }

  /** Configure Regular Channel
  */
  sConfig.Channel = ADC_CHANNEL_10;
  sConfig.Rank = ADC_REGULAR_RANK_2;
  sConfig.SamplingTime = ADC_SAMPLETIME_92CYCLES_5;
  if (HAL_ADC_ConfigChannel(&hadc1, &sConfig) != HAL_OK)
  {
    Error_Handler();
  }

  /** Configure Regular Channel
  */
  sConfig.Channel = ADC_CHANNEL_9;
  sConfig.Rank = ADC_REGULAR_RANK_3;
  if (HAL_ADC_ConfigChannel(&hadc1, &sConfig) != HAL_OK)
  {
    Error_Handler();
  }

  /** Configure Regular Channel
  */
  sConfig.Channel = ADC_CHANNEL_VREFINT;
  sConfig.Rank = ADC_REGULAR_RANK_4;
  sConfig.SamplingTime = ADC_SAMPLETIME_247CYCLES_5;
  if (HAL_ADC_ConfigChannel(&hadc1, &sConfig) != HAL_OK)
  {
    Error_Handler();
  }

  /** Configure Regular Channel
  */
  sConfig.Channel = ADC_CHANNEL_16;
  sConfig.Rank = ADC_REGULAR_RANK_5;
  sConfig.SamplingTime = ADC_SAMPLETIME_92CYCLES_5;
  if (HAL_ADC_ConfigChannel(&hadc1, &sConfig) != HAL_OK)
  {
    Error_Handler();
  }
  /* USER CODE BEGIN ADC1_Init 2 */

  adcChConfig.Channel		= sConfig.Channel;
  adcChConfig.Rank			= sConfig.Rank;
  adcChConfig.SamplingTime	= sConfig.SamplingTime;
  adcChConfig.SingleDiff	= sConfig.SingleDiff;
  adcChConfig.OffsetNumber	= sConfig.OffsetNumber;
  adcChConfig.Offset		= sConfig.Offset;

  /* USER CODE END ADC1_Init 2 */

}

void HAL_ADC_MspInit(ADC_HandleTypeDef* adcHandle)
{

  GPIO_InitTypeDef GPIO_InitStruct = {0};
  RCC_PeriphCLKInitTypeDef PeriphClkInit = {0};
  if(adcHandle->Instance==ADC1)
  {
  /** Initializes the peripherals clock
  */
    PeriphClkInit.PeriphClockSelection = RCC_PERIPHCLK_ADC;
    PeriphClkInit.AdcClockSelection = RCC_ADCCLKSOURCE_SYSCLK;
    if (HAL_RCCEx_PeriphCLKConfig(&PeriphClkInit) != HAL_OK)
    {
      Error_Handler();
    }

    /* ADC1 clock enable */
    __HAL_RCC_ADC_CLK_ENABLE();

    __HAL_RCC_GPIOA_CLK_ENABLE();
    __HAL_RCC_GPIOB_CLK_ENABLE();
    /**ADC1 GPIO Configuration
    PA4     ------> ADC1_IN9
    PA5     ------> ADC1_IN10
    PB1     ------> ADC1_IN16
    */
    GPIO_InitStruct.Pin = A3_V_OCXO_ADC1_IN9_Pin|A4_V_HOLD_ADC1_IN10_Pin;
    GPIO_InitStruct.Mode = GPIO_MODE_ANALOG_ADC_CONTROL;
    GPIO_InitStruct.Pull = GPIO_NOPULL;
    HAL_GPIO_Init(GPIOA, &GPIO_InitStruct);

    GPIO_InitStruct.Pin = D6_V_DCF77_DEMOD_ADC1_IN16_Pin;
    GPIO_InitStruct.Mode = GPIO_MODE_ANALOG_ADC_CONTROL;
    GPIO_InitStruct.Pull = GPIO_NOPULL;
    HAL_GPIO_Init(D6_V_DCF77_DEMOD_ADC1_IN16_GPIO_Port, &GPIO_InitStruct);

    /* ADC1 DMA Init */
    /* ADC1 Init */
    hdma_adc1.Instance = DMA1_Channel1;
    hdma_adc1.Init.Request = DMA_REQUEST_0;
    hdma_adc1.Init.Direction = DMA_PERIPH_TO_MEMORY;
    hdma_adc1.Init.PeriphInc = DMA_PINC_DISABLE;
    hdma_adc1.Init.MemInc = DMA_MINC_ENABLE;
    hdma_adc1.Init.PeriphDataAlignment = DMA_PDATAALIGN_HALFWORD;
    hdma_adc1.Init.MemDataAlignment = DMA_MDATAALIGN_HALFWORD;
    hdma_adc1.Init.Mode = DMA_NORMAL;
    hdma_adc1.Init.Priority = DMA_PRIORITY_MEDIUM;
    if (HAL_DMA_Init(&hdma_adc1) != HAL_OK)
    {
      Error_Handler();
    }

    __HAL_LINKDMA(adcHandle,DMA_Handle,hdma_adc1);

    /* ADC1 interrupt Init */
    HAL_NVIC_SetPriority(ADC1_IRQn, 0, 0);
    HAL_NVIC_EnableIRQ(ADC1_IRQn);
  }
}

void HAL_ADC_MspDeInit(ADC_HandleTypeDef* adcHandle)
{

  if(adcHandle->Instance==ADC1)
  {
    /* Peripheral clock disable */
    __HAL_RCC_ADC_CLK_DISABLE();

    /**ADC1 GPIO Configuration
    PA4     ------> ADC1_IN9
    PA5     ------> ADC1_IN10
    PB1     ------> ADC1_IN16
    */
    HAL_GPIO_DeInit(GPIOA, A3_V_OCXO_ADC1_IN9_Pin|A4_V_HOLD_ADC1_IN10_Pin);

    HAL_GPIO_DeInit(D6_V_DCF77_DEMOD_ADC1_IN16_GPIO_Port, D6_V_DCF77_DEMOD_ADC1_IN16_Pin);

    /* ADC1 DMA DeInit */
    HAL_DMA_DeInit(adcHandle->DMA_Handle);

    /* ADC1 interrupt Deinit */
    HAL_NVIC_DisableIRQ(ADC1_IRQn);
  }
}

/* USER CODE BEGIN 1 */

/**
  * @brief  Enable ADC, start conversion of regular group and transfer result through DMA.
  * @note   Interruptions enabled in this function:
  *         overrun (if applicable), DMA half transfer, DMA transfer complete.
  *         Each of these interruptions has its dedicated callback function.
  * @note   Case of multimode enabled (when multimode feature is available): HAL_ADC_Start_DMA()
  *         is designed for single-ADC mode only. For multimode, the dedicated
  *         HAL_ADCEx_MultiModeStart_DMA() function must be used.
  * @param hadc ADC handle
  * @param pData Destination Buffer address.
  * @param Length Number of data to be transferred from ADC peripheral to memory
  * @retval HAL status.
  */
HAL_StatusTypeDef DF4IAH_ADC_Start_DMA(ADC_HandleTypeDef *hadc, uint32_t *pData, uint32_t Length)
{
  HAL_StatusTypeDef tmp_hal_status;

  /* Check the parameters */
  assert_param(IS_ADC_ALL_INSTANCE(hadc->Instance));

  /* Perform ADC enable and conversion start if no conversion is on going */
  if (LL_ADC_REG_IsConversionOngoing(hadc->Instance) == 0UL)
  {
    /* Process locked */
    __HAL_LOCK(hadc);

    {
      /* Enable the ADC peripheral */
      tmp_hal_status = ADC_Enable(hadc);

      /* Start conversion if ADC is effectively enabled */
      if (tmp_hal_status == HAL_OK)
      {
        /* Set ADC state                                                        */
        /* - Clear state bitfield related to regular group conversion results   */
        /* - Set state bitfield related to regular operation                    */
        ADC_STATE_CLR_SET(hadc->State,
                          HAL_ADC_STATE_READY | HAL_ADC_STATE_REG_EOC | HAL_ADC_STATE_REG_OVR | HAL_ADC_STATE_REG_EOSMP,
                          HAL_ADC_STATE_REG_BUSY);

        /* Check if a conversion is on going on ADC group injected */
        if ((hadc->State & HAL_ADC_STATE_INJ_BUSY) != 0UL)
        {
          /* Reset ADC error code fields related to regular conversions only */
          CLEAR_BIT(hadc->ErrorCode, (HAL_ADC_ERROR_OVR | HAL_ADC_ERROR_DMA));
        }
        else
        {
          /* Reset all ADC error code fields */
          ADC_CLEAR_ERRORCODE(hadc);
        }

        /* Set the DMA transfer complete callback */
        hadc->DMA_Handle->XferCpltCallback = ADC_DMAConvCplt;

        /* Set the DMA half transfer complete callback */
        hadc->DMA_Handle->XferHalfCpltCallback = ADC_DMAHalfConvCplt;

        /* Set the DMA error callback */
        hadc->DMA_Handle->XferErrorCallback = ADC_DMAError;


        /* Manage ADC and DMA start: ADC overrun interruption, DMA start,     */
        /* ADC start (in case of SW start):                                   */

        /* Clear regular group conversion flag and overrun flag               */
        /* (To ensure of no unknown state from potential previous ADC         */
        /* operations)                                                        */
        __HAL_ADC_CLEAR_FLAG(hadc, (ADC_FLAG_EOC | ADC_FLAG_EOS | ADC_FLAG_OVR));

        /* Process unlocked */
        /* Unlock before starting ADC conversions: in case of potential         */
        /* interruption, to let the process to ADC IRQ Handler.                 */
        __HAL_UNLOCK(hadc);

        /* With DMA, overrun event is always considered as an error even if
           hadc->Init.Overrun is set to ADC_OVR_DATA_OVERWRITTEN. Therefore,
           ADC_IT_OVR is enabled. */
        __HAL_ADC_ENABLE_IT(hadc, ADC_IT_OVR);

        /* Enable ADC DMA mode */
        SET_BIT(hadc->Instance->CFGR, ADC_CFGR_DMAEN);

        /* DF4IAH: Re-Init the DMA Channel 1 */
        HAL_DMA_Init(hadc->DMA_Handle);

        /* Start the DMA channel */
        tmp_hal_status = HAL_DMA_Start_IT(hadc->DMA_Handle, (uint32_t)&hadc->Instance->DR, (uint32_t)pData, Length);

        /* Enable conversion of regular group.                                  */
        /* If software start has been selected, conversion starts immediately.  */
        /* If external trigger has been selected, conversion will start at next */
        /* trigger event.                                                       */
        /* Start ADC group regular conversion */
        LL_ADC_REG_StartConversion(hadc->Instance);
      }
      else
      {
        /* Process unlocked */
        __HAL_UNLOCK(hadc);
      }

    }
  }
  else
  {
    tmp_hal_status = HAL_BUSY;
  }

  /* Return function status */
  return tmp_hal_status;
}


void HAL_ADC_ConvCpltCallback(ADC_HandleTypeDef *hadc)
{
	if (HAL_ADC_GetState(hadc) & HAL_ADC_STATE_REG_EOC) {
		uint32_t status = READ_REG(hadc->Instance->ISR);
		if (status & ADC_FLAG_EOS) {
			/* Sequence has finished */
			__HAL_ADC_CLEAR_FLAG(hadc, ADC_FLAG_EOS);

			/* Copy from DMA out region to global variables */
			{
				/* Get the converted value of regular channel */
				gAdcVrefint_val = adc_dma_buf[0];

				/* Get the converted value of regular channel */
				gAdcCh10_val = adc_dma_buf[1];

				/* Get the converted value of regular channel */
				gAdcCh9_val = adc_dma_buf[2];

				/* Get the converted value of regular channel */
				gAdcCh16_val = adc_dma_buf[4];
			}
		}
	}

#if 0
	// HAL_ADC_GetValue(hadc);

	if (status & ADC_FLAG_OVR) {
		__HAL_ADC_CLEAR_FLAG(hadc, ADC_FLAG_OVR);
	}
#endif
}

/* For single transfer not in use */
#if 0
/* DMA 1/2 completion */
void HAL_ADC_ConvHalfCpltCallback(ADC_HandleTypeDef *hadc)
{
}
#endif

void HAL_ADC_ErrorCallback(ADC_HandleTypeDef *hadc)
{
	static uint32_t ctr = 0UL;
	++ctr;
}


void adc_init(void)
{
	if (HAL_ADCEx_Calibration_Start(&hadc1, ADC_SINGLE_ENDED) !=  HAL_OK)
	{
		Error_Handler();
	}
}

void adc_start(void)
{
	if (HAL_ADC_GetState(&hadc1) & HAL_ADC_STATE_READY) {
		if (DF4IAH_ADC_Start_DMA(&hadc1, (uint32_t*) adc_dma_buf, ADC_DMA_Buf_Len) != HAL_OK) {
			Error_Handler();
		}
	}
}

void adc_stop(void)
{
	if ((HAL_ADC_GetState(&hadc1) & HAL_ADC_STATE_READY) == 0) {
		HAL_ADC_Stop_DMA(&hadc1);
	}
	else {
		if (__HAL_ADC_GET_FLAG(&hadc1, ADC_FLAG_EOS)) {
			__HAL_ADC_CLEAR_FLAG(&hadc1, ADC_FLAG_EOS);
		}
	}
}

/* USER CODE END 1 */
