mfkiwl/GPSDO_by_DF4IAH/(commit log)

2021-09-23 SW - initial setup of the Nucleo-32 STM32L432KC
2021-09-25 HW/CAD/FreeCAD - Case from Christian Klosik added
2021-09-26 SW - change from FreeRTOS to bare due to very high interrupt rate of ISR needed
2021-10-03 SW - third pinout variant with sandwich PCB for routed signals, HoRelay and GPS link works
2021-10-04 SW - I2C interface added, DAC set to high imp and adjusted to 2.1 volts for OCXO
2021-10-05 SW - 1-wire interface established, temp sensor DS18B20 works
2021-10-07 SW - ADC with HAL code seems to make much trouble... - more to come
2021-10-08 SW - ADC works, no offset corrections yet
    [GPSDO_by_DF4IAH.ioc, adc.c, main.c]
2021-10-08 SW - ADC with correction by internal reference diode added
    [GPSDO_by_DF4IAH.ioc, adc.c, main.c, usart.c]
2021-10-10 SW - Onewire now works for more than one sensor on the bus
2021-10-11 SW - ADC slower clock for better results
2021-10-11 SW - DAC enabled for fine tuning, ADC clock reverted
    [GPSDO_by_DF4IAH.ioc, adc.c, i2c.h, main.c]
2021-10-11 SW - major bugs of software implementation of PLL fixed
    [i2c.h, main.c]
2021-10-11 SW - cold start bugs fixed
    [main.c]
2021-10-11 SW - multiple minor fixes for the soft PLL
    [gpio.c, main.c, tim.c]
2021-10-11 SW - widen max. drift for GPS to +-250ns instead of +-100ns
    [main.c]
2021-10-14 SW - fix for Locked-LED, ps/s instead of PPMs
    [main.c, tim.c]
2021-10-15 SW - fix for LCD_16x2
    [i2c.c, main.c]
2021-10-15 SW - fix for LCD_16x2 (2)
    [i2c.c, main.c]
2021-10-15 SW - fix for LCD_16x2 (3)
    [i2c.c]
2021-10-16 SW - LCD240x128 timing problem solved
    [i2c.c]
2021-10-18 SW - Status LED now showing spare time of the second cycle LOOP
2021-10-18 SW - bad temp sensor meassurements fixed
    [gpio.c, i2c.c, main.c]
2021-10-18 SW - LCD240x120 - restriced time for printing data added
2021-10-19 SW - LCD240x128 ADC plot works
2021-10-19 SW - multiple minor fixes
    [i2c.c, main.c, tim.c, usart.c]
2021-10-19 SW - early hold relay setting added
2021-10-19 SW - remove pull-down at hold relay output
2021-10-20 SW - LCD240x128 overflow when azimuth 90 deg fixed
    [i2c.c]
2021-10-20 SW - Software-PLL - sign fix, much better response to phase errors
    [main.c]
2021-10-23 HW - Eagle - first design for a board to receive DCF77
    [DCF77_RX_1V0.brd, DCF77_RX_1V0.sch]
2021-10-24 SW - refactoring global interrupt variables
2021-10-24 HW - Simulation - preamplifier, crystal and driver
2021-10-24 HW - Eagle - adaptions from simulation made, layout to do
    [DCF77_RX_1V0.brd, DCF77_RX_1V0.sch]
2021-10-24 HW - Eagle - Hardware ready for the PCB house V1.0
    [DCF77_RX_1V0.brd, DCF77_RX_1V0.sch]
2021-10-24 HW - Eagle - V1.0 previews
    [DCF77_RX_1V0.brd]
2021-10-26 SW - interrupt disabled for TIM2 during Onewire critical sections
2021-10-27 SW - preparing TIM2_IC_CH4 for DMA
2021-10-28 SW - DCF77 DMA buffer handling
2021-10-31 HW - Eagle - most of hardware is done
    [sGPSDO_MCU_1V0.brd, sGPSDO_MCU_1V0.sch]
2021-10-31 HW - Eagle - sGPSDO_MCU hardware ready for the PCB house V1.0
    [DCF77_RX_1V0.brd, sGPSDO_MCU_1V0.brd]
2021-11-01 CPLD - MCU_divider_31to_1 - Not in use but possible replacement for 74HC4059 divider.
    [div_mod_pad.csv]
2021-11-02 HW - CAD/FreeCAD - front and bottom part done.
2022-06-30 SW - update to STM32CubeMX V6.6.0, STM32CubeIDE V1.10.0
